Koede/cephalo-1/spec-sheet/page/index.html

Cephalo-1 octopus drone · main arm · spec sheet

# Pin-hinge arm, no helix

1.00 m, 13 joints, hinge axes turning 90 deg per joint. Computed Nov 10, 2026 from the CAD masses and the joint study model.

## What the numbers say

- Hover: lean the fan about 20 deg and the arm holds at 0.18 of stall
  With the fan kept upright (within 3 deg) the best pose found puts 0.67 of stall on joint 2 at hover and 1.42 at full thrust: over your 2x rule, and joint 2 overheats. Let the fan lean off vertical (the eight arms' sideways pushes cancel) and thrust starts carrying the arm: 10 deg gives 0.38 for 1.5 % of lift, 20 deg gives 0.18 at hover and 0.37 at full thrust for 6 % of lift.
- It cannot hold itself out straight with the fan off
  Straight and level, joint 2 needs 1.30 of stall (the helix arm's worst is 1.10). Arched up with the tip held level, it reaches 0.95 m from the root under stall and 0.50 m under your 2x rule. Carrying anything held out needs the fan's help or a short reach.
- Walking on the folded pod: feet need to sit about 45 cm out
  With the feet 30 cm from the hub axis the outer joints (7 to 9, STS3215) run at 1.28 of stall, and 2.75 at twice the foot load. At 35 cm the worst is 0.69; at 45 cm it drops to 0.48, inside your 2x rule. The fold that brings a 1 m arm down to a near foot puts the foot load across the outer joints. 25 cm was out of reach under these clearance rules for both arms.
- The horn screws are the loosest link
  Four M3 screws through 3.4 mm holes in PETG hold 7.0 N.m by friction when new and about 3.5 N.m once the plastic relaxes, which is under an STS3250's 4.9 N.m stall. When it slips, the hole clearance adds up to 1.64 deg of play at that joint. Ream to 3.1 mm and add washers, or bond the ear to the horn.
- Tip play: 9 mm typical, 35 mm worst case as designed; 4 times that if the horn clamps slip
  Servo backlash (0.5 deg each, assumed) is 90 % of it. The 8.4 mm printed idler bores add half again; reamed to 8.05 to 8.10 mm they add almost nothing. Gravity and thrust usually hold every joint against one side of its play, so the tip only wanders this much when the load reverses.
- Root gear contact stress is the long-run limit at joint 0
  At stall the m1 7075 pair sees 547 MPa contact and 155 MPa root bending, fine for peaks; at hover it sees 373 MPa. Anodized aluminium pits under long running above roughly 350 MPa. A steel pinion removes the question.
- Weakest printed part: joint 0 idler ear, safety factor 2.1
  Across every solved hover, tilt, full-thrust and 2x walking load, with PETG at 25 MPa across the layers. Everything clears your 2x rule.
- Servo heat decides the hover pose
  With the fan upright, joint 0 reaches a 50 K rise in 5.5 min, joint 2 reaches a 50 K rise in 2.7 min, joint 4 reaches a 50 K rise in 16.4 min, against a 17 minute flight, and the arm's servos burn 72.8 W. In the 20 deg leaning pose the arm burns 23.4 W and no servo overheats in a flight. A holding servo turns all its input into heat; about 3 W per case is the steady limit (assumed), roughly a fifth of stall torque.
- Landing: it has to land under power
  Dropped 5 cm onto seven folded-pod feet with the servos as the only spring, each foot takes about 86 N and the worst joint sees 3.6 times stall, enough to back-drive or strip a gear train. Let thrust carry the weight to touchdown and hand it over slowly, or add a soft foot pad.

## Configuration and method

- Arm: 1.00 m, 13 pin-hinge joints at 76.9 mm pitch, 57.1 mm outer diameter. Hinge axes turn 90 deg from one joint to the next, so joints alternate pitch (even: 0, 2 … 12) and yaw (odd). That is the closest no-helix layout to the helix arm: same parts, one vertebra STL for every moving link, and pitch and yaw stay separated.
- Servos: STS3250 (4.9 N.m stall, 12 V) in joints 0 to 4, STS3215 (2.94 N.m) in joints 5 to 12, a 2:1 m1 7075 spur stage on joint 0 (9.8 N.m). 6705 support bearings on the horn side of joints 1 to 4, 7075 idler pins on 0 to 4, printed 8 mm PETG stubs on 5 to 12.
- Tip: folding fan pod, 252.5 g, MN5008 KV400 with a 16x5.4 prop 102 mm out; thrust acts along the tip axis.
- Robot: 19.15 kg with the claw-fan wiring. Hover split: 21.53 N per claw fan and 16.2 N from the central prop, about 2820 W.
- Method: hand calculations and a rigid-body model of the arm built from the CAD masses (no FEA). Poses are found by optimisation: each one minimises the worst joint's share of stall under its geometric constraints, from many random starts, so a lower-torque pose may still exist. Tolerances use a 20,000-sample Monte Carlo. Values marked [A] are assumptions; the full list is at the end.

Model, scripts and raw results: octopus-drone/spec-sheet in the project files (spec_lib.py, sec1 to sec5, results/). CAD regenerated without the helix: spec-sheet/cad_alt90.

## Geometry, mass and inertia

Arm, root socket to tip pod1700.4 g

Links (13 vertebrae, servos, lids, bearings, wiring)1316.5 g

Tip pod252.5 g

Root, fixed to the mantle131.4 g

Eight arms13.6 kg (72% of the robot)

Moving mass per arm1.569 kg

CG, arm straight557.7 mm from joint 0

Inertia about the root pitch axis0.6652 kg·m²

Gravity moment at the root, straight out8.58 N.m

Servos per arm5 STS3250, 8 STS3215, 1 STS3032 (pod)

Link | Between | Mass g | CG from joint mm | Servo it carries
0 | joint 0 to 1 | 137.6 | 51.9 | STS3250
1 | joint 1 to 2 | 123.5 | 57.8 | STS3250
2 | joint 2 to 3 | 123.5 | 57.8 | STS3250
3 | joint 3 to 4 | 123.5 | 57.8 | STS3250
4 | joint 4 to 5 | 96.4 | 54.7 | STS3215
5 | joint 5 to 6 | 95.4 | 55.3 | STS3215
6 | joint 6 to 7 | 95.4 | 55.3 | STS3215
7 | joint 7 to 8 | 95.4 | 55.3 | STS3215
8 | joint 8 to 9 | 95.4 | 55.3 | STS3215
9 | joint 9 to 10 | 95.4 | 55.3 | STS3215
10 | joint 10 to 11 | 95.4 | 55.3 | STS3215
11 | joint 11 to 12 | 95.4 | 55.3 | STS3215
12 | joint 12 to tip plate | 44.1 | 45.1 | none

Joint-space inertia (diagonal, arm straight, kg·m²): 0.666, 0.541, 0.432, 0.340, 0.262, 0.197, 0.143, 0.101, 0.067, 0.042, 0.024, 0.012, 0.005.

## Reach, workspace and degrees of freedom

Turning every hinge by 90 deg instead of 60 deg costs almost nothing in reach or workspace. What changes is that pure pitch now uses only every other joint, so the arm bends in coarser steps.

| No helix (90 deg) | Helix (60 deg)
Workspace volume | 0.457 m³ | 0.459 m³
Reach, max / median / min | 0.985 / 0.833 / 0.201 m | 0.985 / 0.832 / 0.248 m
Pitch / yaw joints | 7 / 6 | 13 spread over 3 directions
Shape fit, mean RMS over the study shapes | 33.0 mm | 31.8 mm

Degrees of freedom13 (plus the pod fold)

Command range±45 deg per joint; joints 0, 1 and 12 clear to ±90 deg, neighbours together to ±60

Tightest curl195.9 mm radius (pitch joints 153.8 mm apart, 45 deg each)

Full pitch curl, tip ends at[-208.2, 0.0, 54.4] mm from joint 0

Position resolution4096 counts per turn: 0.088 deg (0.044 deg at joint 0); about 1 mm at the tip, straight

Manipulability, straightsingular values 1.64, 1.47, 0 (no reach along the arm when straight)

## Joint torque demand

hover, fan uprighthover, fan leaning 20 degwalking stance (worst)straight out, fan off

Share of stall torque per joint in the main poses

Flight case | Fan thrust | Worst need | At | Lift lost to lean | Helix arm
Fan upright (within 3 deg), hover | 21.5 N | 0.67 | joint 2 | 0.1% | 0.63
Fan upright (within 3 deg), rated | 25.1 N | 0.89 | joint 2 | 0.1% | 1.04
Fan upright (within 3 deg), full | 33.5 N | 1.42 | joint 2 | 0.1% | 1.60
Fan leaning up to 10 deg, hover | 21.5 N | 0.38 | joint 2 | 1.5% | –
Fan leaning up to 10 deg, rated | 25.1 N | 0.56 | joint 2 | 1.5% | –
Fan leaning up to 10 deg, full | 33.5 N | 0.97 | joint 2 | 1.5% | –
Fan leaning up to 20 deg, hover | 21.5 N | 0.18 | joint 7 | 6.0% | –
Fan leaning up to 20 deg, rated | 25.1 N | 0.23 | joint 10 | 6.0% | –
Fan leaning up to 20 deg, full | 33.5 N | 0.37 | joint 10 | 6.0% | –
Rated thrust, fan tilted 30 deg out | 25.1 N | 0.41 | joint 1 | – | 0.41
Rated thrust, fan tilted 30 deg in | 25.1 N | 1.66 | joint 5 | – | 1.60
Rated thrust, fan tilted 30 deg side | 25.1 N | 1.22 | joint 1 | – | 1.48

Need = joint torque / stall. Green under 0.5 (your 2x rule), amber 0.5 to 1, red above stall. Every pose keeps the fan at least 0.60 m from the robot centre so the 16 in discs clear each other. Leaning fans push sideways; the eight arms' pushes cancel. Poses come from many random starts, so lower ones may exist.

### Walking stance on the folded pod

Arm | Foot radius from the hub axis | Foot points reachable | Worst need | At 2x foot load
No helix | 30 cm | 6/9 | 1.28 | 2.75
No helix | 35 cm | 1/1 | 0.69 | 1.54
No helix | 45 cm | 2/2 | 0.48 | 1.37
Helix | 25 cm | 0/2 | no pose | –
Helix | 30 cm | 0/1 | no pose | –
Helix | 45 cm | 1/1 | 0.56 | 1.52

Same constraints for both arms: hub 250 mm up, tip within 10 deg of down, every link 15 mm clear of the ground and inside its own 36 deg wedge so it cannot reach a neighbour. The design notes' helix stance used a 110 mm hub radius and a direct neighbour check, which is why it found poses at 25 cm.

Pod clocking | Foot | Feasible starts | Worst need | At 2x foot load
pod +x | mid | 0/36 | no pose | –
pod +x | side +45 | 17/36 | 0.99 | 2.17
pod +x | in 34 | 0/36 | no pose | –
pod +y | mid | 21/36 | 1.02 | 2.21
pod +y | side +45 | 18/36 | 1.17 | 2.52
pod +y | in 34 | 19/36 | 1.28 | 2.75
pod -x | mid | 33/36 | 1.01 | 2.24
pod -x | side +45 | 20/36 | 1.02 | 2.25
pod -x | in 34 | 0/36 | no pose | –

Foot = the folded pod's finger tip, with the hub 250 mm above the ground and the tip axis within 10 deg of straight down; 'mid', 'side +45' (45 mm sideways) and 'in 34' (34 mm inward) are three points of the study's step. Pod clocking = which way the folded finger points. Each case: 36 random starts moved onto the constraints, then the best of up to six optimised. 'No pose' means none of the 36 starts reached that foot point.

### Holding the arm out

Tip held level at | Worst need, fan off | Payload at 2x rule kg | Payload to stall kg | Helix arm, worst need
0.30 m | 0.33 | 0.54 | 2.16 | –
0.50 m | 0.44 | 0.09 | 1.01 | –
0.60 m | 0.52 | 0 | 0.68 | –
0.70 m | 0.59 | 0 | 0.49 | –
0.80 m | 0.68 | 0 | 0.38 | –
0.90 m | 0.76 | 0 | 0.23 | –
0.95 m | 0.93 | 0 | 0.05 | –

Tip plate held at that distance from joint 0, level with the root, fan off; payload hangs from the tip plate.

Random poses (±45 deg), thrust along the tip axis | Held at stall | Held under the 2x rule | Helix arm, held at stall
off | 75% | 9% | 95%
hover | 11% | 1% | 12%
rated | 7% | 0% | 7%

1500 random poses each.

## Speed and bandwidth

Case | 0 | 1 | 2 | 3 | 4 | 5 | 6 | 7 | 8 | 9 | 10 | 11 | 12
No load | 2.2 | 4.4 | 4.4 | 4.4 | 4.4 | 4.7 | 4.7 | 4.7 | 4.7 | 4.7 | 4.7 | 4.7 | 4.7
fans off, straight | 0.3 | 4.4 | 0 | 4.4 | 0.3 | 4.7 | 0 | 4.7 | 1.7 | 4.7 | 3.2 | 4.7 | 4.2
hover, fan upright | 1.2 | 4.2 | 1.4 | 4 | 3.1 | 2.5 | 3.8 | 2.8 | 4.3 | 3.7 | 4.4 | 4.7 | 4.7
hover, fan leaning 20 deg | 2.2 | 4.1 | 4.3 | 4 | 4.4 | 3.9 | 4.5 | 3.8 | 4.1 | 4.3 | 3.9 | 4.7 | 4.5

Joint speed in rad/s, derated linearly with the torque each joint is holding (speed falls to zero at stall). Joint 0 runs at half the servo's speed through the 2:1 stage.

Tip speed, joint 0 alone2.2 m/s

Tip speed, all pitch joints together14.75 m/s

First modes, straight1.58 Hz, 1.71 Hz, 9.34 Hz, 9.63 Hz

First modes, hover, fan upright1.93 Hz, 2.43 Hz, 7.23 Hz, 8.02 Hz

First modes, hover, leaning 20 deg1.67 Hz, 1.74 Hz, 9.47 Hz, 9.66 Hz

Servo bus, one per arm at 1 Mbit/s2.89 ms per write-and-read cycle, about 346 Hz

Prop once-per-rev at hoverabout 80 Hz, well above the arm modes

Joint-space modes with the servo hold stiffness above; real servo loops add damping and lag, so treat these as upper bounds. Keep the flight controller's attitude loop under about a third of the first mode, and the prop's once-per-rev (about 80 Hz at hover) is far above them.

## Tolerances, fits and backlash

Part | Fit | Loosens at +40 K, mm | Note
61803 outer ring (26 mm) in printed socket boss | light press, 0.03 to 0.08 mm interference on the as-printed bore (print 25.90, ream or sand to fit) | 0.059 | PETG grows 0.06 mm more than the steel ring at +40 K: a 0.03 mm press is gone by +20 K. Bond the ring with epoxy or keep a lip and a cap.
61803 inner ring (17 mm) on the 7075 gear spigot | 17 k5 (+0.012 / +0.001) on a solid spigot; the hollow spigot as drawn is thin, so 17 j5 (+0.005 / -0.003) plus retaining compound | 0.008 | aluminium grows 0.008 mm more than the ring at +40 K, which tightens this fit slightly
695 outer ring (13 mm) in the printed bearing cap | light press 0.02 to 0.05 mm, bonded | 0.029
695 inner ring on the 5 mm pinion stub | 5 k5 (+0.006 / +0.001) | 0
6705 outer ring (32 mm) in the printed lid ring, joints 1 to 4 | 0 to 0.05 mm interference, bonded | 0.072 | 0.07 mm of loosening at +40 K
6705 inner ring (25 mm) on the printed fork sleeve, joints 1 to 4 | 0.05 to 0.10 mm interference on a sanded sleeve (print 25.20, sand to fit); a printed sleeve creeps, so bond it | -0.057 | the sleeve grows into the ring when warm (tightens 0.04 mm at +40 K); the risk is creep at room temperature
8 mm 7075 idler pin in the printed cheek (joint 0) or cradle back (joints 1 to 4) | pin 8 h6 (0 / -0.009); printed hole 7.80 to 7.85 mm, pressed (0.15 to 0.2 mm into PETG) or bonded in an 8.0 mm hole | 0.014
Fork idler ear on the 8 mm pin or stub (running) | running clearance 0.05 to 0.10 mm diametral: print the bore at 8.0 and ream 8.05 to 8.10, or press an 8 x 10 x 4 mm PTFE or iglide bushing into a 10 mm bore | 0 | as drawn the bore is 8.4 mm (0.4 mm clearance): see the stack-up
Horn screws, 4 x M3 through the 4 mm fork horn ear | clearance hole 3.4 mm as drawn; ream 3.1 mm (or print 3.0 and drill 3.1) | 0 | see the horn clamp check: PETG relaxes the clamp, and then the hole clearance becomes backlash
Gear and pinion centre (30 mm) | +-0.02 mm with reamed seats; +0.05 mm nominal if printed | 0.053 | the printed socket grows 0.05 mm more than the gears at +40 K, which adds 0.04 mm of backlash when hot
Joint pitch (76.92 mm) | +-0.2 mm per printed vertebra (FDM, along the arm axis) | 0.209 | 13 in a row: +-2.6 mm worst case, +-0.7 mm RSS in arm length
PTFE thrust washer, idler ear to cradle floor | 0.5 mm washer; end play 0.05 to 0.15 mm, set with 0.1 mm shims | 0
Servo in its pocket | 0.5 mm clearance per side as drawn; the lid clamps it | 0

### Root gear backlash

Normal backlash mm | Joint 0 play deg
0.03 | 0.091
0.05 | 0.152
0.08 | 0.244
0.1 | 0.305

design normal backlash 0.05 mm (0.15 deg at the joint); bore the gear and pinion bearing seats in one setup or ream them in a drilling jig so the centre distance holds +-0.02 mm; a printed socket alone holds about +-0.1 mm, which swings the backlash from 0 (binding) to 0.12 mm. Set the nominal centre 0.05 mm long (30.05 mm) if the seats stay as printed. each 0.01 mm of centre-distance error changes normal backlash by 2 x 0.01 x tan 20 deg = 0.0073 mm.

### Tip error from play

Build | Pose | RMS mm | 95 % mm | Worst case mm | From hinge backlash
as designed (reamed bores, horn clamp holding, gear 0.05 mm) | straight out | 5.4 | 9.2 | 35.4 | 84%
as designed (reamed bores, horn clamp holding, gear 0.05 mm) | hover pose | 4.2 | 7.2 | 30.4 | 75%
as drawn (8.4 mm bores), horn clamp holding | straight out | 7.4 | 12.7 | 58.2 | 51%
as drawn (8.4 mm bores), horn clamp holding | hover pose | 6.6 | 11.2 | 60.3 | 38%
as drawn, horn clamp relaxed (3.4 mm holes slip) | straight out | 42.1 | 71.1 | 258.2 | 89%
as drawn, horn clamp relaxed (3.4 mm holes slip) | hover pose | 32 | 54.9 | 214.5 | 83%

play only: servo backlash 0.5 deg [A, no maker figure], halved by the 2:1 stage plus the stage's own; idler bore clearance tilts the fork about the two cross axes over the 49 mm ear span; horn-hole slip once the clamp has relaxed. Uniform within each play, 20,000 samples. Gravity or thrust usually preloads every joint to one side of its play, so the repeatable error under a steady load is far smaller than these numbers; they are what the tip can wander when the load reverses.

Horn clamp, new / relaxed7.0 / 3.5 N.m by friction

Arm length tolerance±2.6 mm worst, ±0.72 mm RSS (±0.2 mm per printed link)

Thermal growth0.6 mm per 10 K over the metre

Encoder step at the tip, joint 11.42 mm

## Stiffness and sag

Sag is set almost entirely by how hard each servo holds its position. The printed links are far stiffer than the joints.

Load case | Tip moves (x, y, z) mm | Total mm
straight out, fans off | 0, 0, -110.8 | 110.8
hover pose, hover thrust | -36.5, -9.9, 17.6 | 41.7
hover pose, full thrust | -75.1, -14.6, 36.6 | 84.9
leaning hover pose (20 deg), hover thrust | -3.8, -12, 2.5 | 12.8
stance +x pod, foot load | -25.2, -14.1, 16 | 33
stance +y pod, foot load | -34, 21.9, 16.2 | 43.6
stance -x pod, foot load | -26.9, -20.1, 14.6 | 36.6

Tip stiffness straight, up0.06 N/mm

Tip stiffness straight, sideways0.052 N/mm

Tip stiffness straight, along the armrigid in this model

Servo hold stiffness taken as stall torque per 2 deg of position error [A]: STS3250 140, STS3215 84 N.m/rad, joint 0 550 through the 2:1 stage. Hinge tilt from ear stretch about 4309 N.m/rad [A]. The ring tube (PETG, 2 mm wall) is about 100 times stiffer than the joints and is left rigid. Clearance tilt is play, not spring: see the stack-up.

## Stresses and safety factors

Joint | Pin | Max servo torque N.m | Horn side N | Idler side N | Horn ear MPa | Idler ear MPa | Bore MPa | Pin bend MPa | Min SF | Weakest
0 | 7075 pin | 10.13 | 175 | 162 | 10 | 11.7 | 6.3 | 6.7 | 2.1 | idler ear
1 | 7075 pin | 7.15 | 179 | 177 | 2.3 | 2.8 | 6.9 | 7.4 | 5.1 | idler bore
2 | 7075 pin | 7.21 | 140 | 128 | 2.2 | 2 | 5 | 5.3 | 7 | idler bore
3 | 7075 pin | 5.94 | 145 | 132 | 2.2 | 2 | 5.2 | 5.5 | 6.8 | idler bore
4 | 7075 pin | 5.42 | 123 | 121 | 5.8 | 7.8 | 4.7 | 5.1 | 3.2 | idler ear
5 | printed PETG stub | 4.89 | 114 | 104 | 5.7 | 6.4 | 4.1 | 4.4 | 3.9 | idler ear
6 | printed PETG stub | 5.91 | 132 | 100 | 8.3 | 7.5 | 3.9 | 4.2 | 3 | horn ear
7 | printed PETG stub | 7.29 | 142 | 174 | 2.7 | 3.2 | 6.8 | 7.3 | 4.3 | pin shear
8 | printed PETG stub | 7.4 | 201 | 166 | 10.8 | 10.6 | 6.5 | 6.9 | 2.3 | horn ear
9 | printed PETG stub | 8.07 | 120 | 168 | 2 | 3.9 | 6.5 | 7 | 4.5 | pin shear
10 | printed PETG stub | 5.55 | 142 | 118 | 8.7 | 7.5 | 4.6 | 4.9 | 2.9 | horn ear
11 | printed PETG stub | 3.64 | 58 | 95 | 2.3 | 7.3 | 3.7 | 4 | 3.4 | idler ear
12 | printed PETG stub | 2.55 | 99 | 52 | 5.4 | 3.6 | 2 | 2.2 | 4.7 | horn ear

Envelope over every solved pose and load: straight out with fans off, hover, rated and full thrust, rated thrust tilted 30 deg, walking stance at 1x and 2x foot load. Ear: in-plane bending over the 20.8 mm ear plus direct pull, across the layers. Limits: PETG 25 MPa across layers, 45 along, 35 MPa bearing [A]; 7075-T6 yield 503, shear 290 MPa. Forest's rule is SF >= 2.

### Root gear

Case | Joint torque N.m | Tooth force N | Lewis pinion MPa | Lewis gear MPa | Contact MPa
stall (9.8 N.m) | 9.8 | 500 | 155 | 129 | 547
hover | 4.57 | 233 | 72 | 60 | 373
full thrust | 10.13 | 517 | 160 | 133 | 556
worst solved pose | 10.13 | 517 | 160 | 133 | 556

Lewis Y 0.322 (20T) and 0.389 (40T), 10 mm face, m1. Contact stress at stall is about 540 MPa: fine for short peaks, but hard-anodized 7075 pits under long running above roughly 350 MPa, so keep joint 0 under about 40 % of stall for sustained loads, or make the pinion steel. 7075-T6: yield 503 MPa, bending fatigue about 159 MPa.

### Servo output side load, joints 5 to 12 (no support bearing)

Joint | Horn side load N | Against 40 N (XM430 reference)
5 | 114.2 | 0.4
6 | 132.3 | 0.3
7 | 142 | 0.3
8 | 201 | 0.2
9 | 120.2 | 0.3
10 | 141.7 | 0.3
11 | 58 | 0.7
12 | 98.8 | 0.4

Feetech publishes no side-load limit; ROBOTIS allows 40 N on the similar XM430, used here as a yardstick. The column shows 40 N divided by the load.

Root flange screws (8 x M3)153.1 N worst, safety factor 11.8

Lid screws (4 x M2 into PETG)43.0 N axial worst, safety factor 14.0

## Fatigue and bearing life

Joint | Support load swing N | Ear stress swing MPa | Ear cycles | Pin stress swing MPa | Pin cycles
0 | 2.2 | 0.17 | 1.0e12 | 0.09 | 1.0e12
1 | 12.4 | 0.95 | 1.0e12 | 0.52 | 1.0e12
2 | 2.2 | 0.17 | 1.0e12 | 0.09 | 1.0e12
3 | 0.3 | 0.02 | 1.0e12 | 0.01 | 1.0e12
4 | 5.1 | 0.39 | 1.0e12 | 0.21 | 1.0e12
5 | 23.2 | 1.78 | 1.0e12 | 0.97 | 1.0e12
6 | 27.7 | 2.12 | 1.0e12 | 1.16 | 1.0e12
7 | 33.6 | 2.58 | 2.0e11 | 1.4 | 1.0e12
8 | 38.6 | 2.96 | 3.9e10 | 1.61 | 1.0e12
9 | 32 | 2.45 | 3.6e11 | 1.34 | 1.0e12
10 | 29.5 | 2.27 | 9.2e11 | 1.23 | 1.0e12
11 | 20.4 | 1.56 | 1.0e12 | 0.85 | 1.0e12
12 | 22.8 | 1.75 | 1.0e12 | 0.95 | 1.0e12

One walking step is one load cycle per joint: swing (arm unloaded) to stance (foot load). Basquin: 7075 sigma_f' 1466 MPa, b -0.143; printed PETG across layers sigma_f' 25 MPa, b -0.085 (about 30 % of strength at a million cycles) [A]. Mean stress ignored; printed parts scatter widely, so divide lives by 10 for design.

Joint | Bearing | C / C0 N | Worst static N | Static SF | Stance load N | L10, ±15 deg swings | L10, ±45 deg swings
0 | 61803 (gear) | 2030 / 1270 | 175 | 7.3 | 24 | 3.4e12 | 1.1e12
1 | 6705 (horn side) | 1079 / 834 | 179 | 4.7 | 27 | 4.0e11 | 1.3e11
2 | 6705 (horn side) | 1079 / 834 | 140 | 6 | 25 | 4.9e11 | 1.6e11
3 | 6705 (horn side) | 1079 / 834 | 145 | 5.8 | 29 | 3.0e11 | 1.0e11
4 | 6705 (horn side) | 1079 / 834 | 123 | 6.8 | 28 | 3.5e11 | 1.2e11

Oscillating L10 = (C/P)^3 x 1e6 x 360 / (4 psi). Small swings under 10 deg do not roll the balls far enough to spread grease: expect false brinelling marks at the hover hold angles; a sweep through the full range now and then (a 'grease cycle' at power-up) helps.

## Efficiencies

Stage | Value
Claw fan at hover | 21.53 N for 306.0 W: 7.17 g/W
Claw fan figure of merit (motor and ESC included) | 0.58 (ideal momentum power 177.2 W)
Claw fan at rated / full | 6.68 / 5.78 g/W
Root gear stage | 0.98 (mesh and two bearings) [A]
Servos holding hover, fan upright | 72.8 W per arm, 583 W for the robot (20.7% of hover power)
Servos holding hover, leaning 20 deg | 23.4 W per arm, 187 W for the robot; the lean costs 29.4 W more fan power per arm
Fan wiring, 16 AWG, hover / full | 7.3 W (0.5 V drop) / 27.1 W (0.96 V)
Whole arm at hover | 5.69 g of thrust per W, servos and wiring included

Joint | 0 | 1 | 2 | 3 | 4 | 5 | 6 | 7 | 8 | 9 | 10 | 11 | 12
Upright: torque N.m | 2.33 | 0.18 | 3.29 | 0.39 | 1.39 | 1.4 | 0.55 | 1.2 | 0.23 | 0.6 | 0.17 | 0.01 | 0.02
Upright: heat W | 12.8 | 1.5 | 24.2 | 1.8 | 5.5 | 8.8 | 2.6 | 6.8 | 1.6 | 2.8 | 1.6 | 1.4 | 1.4
Leaning: torque N.m | 0.09 | 0.3 | 0.08 | 0.5 | 0.05 | 0.51 | 0.12 | 0.54 | 0.37 | 0.24 | 0.52 | 0.01 | 0.11
Leaning: heat W | 1.5 | 1.6 | 1.4 | 2 | 1.4 | 2.4 | 1.5 | 2.5 | 2 | 1.6 | 2.5 | 1.4 | 1.5

Servo current in the hover pose = torque / (stall torque / stall current); a holding servo turns it all to heat (I²R plus 0.12 A of electronics at 12 V).

## Thermal

Servo | Winding Ω | N.m per A | Continuous torque N.m | Share of stall | Time constant s
STS3250 | 2.86 | 1.167 | 0.86 | 18% | 1242
STS3215 | 4.44 | 1.089 | 0.65 | 22% | 917

Joint | Upright: heat W | Upright: minutes to +50 K | Leaning 20 deg: heat W | Leaning: minutes to +50 K
0 | 12.8 | 5.5 | 1.5 | never
1 | 1.5 | never | 1.6 | never
2 | 24.2 | 2.7 | 1.4 | never
3 | 1.8 | never | 2 | never
4 | 5.5 | 16.4 | 1.4 | never
5 | 8.8 | 6.4 | 2.4 | never
6 | 2.6 | never | 1.5 | never
7 | 6.8 | 8.8 | 2.5 | never
8 | 1.6 | never | 2 | never
9 | 2.8 | never | 1.6 | never
10 | 1.6 | never | 2.5 | never
11 | 1.4 | never | 1.4 | never
12 | 1.4 | never | 1.5 | never

About 3 W of steady heat per servo case in still air [A]; in the prop wash it is better. 50 K rise from 25 C ambient keeps the case near 75 C, under the 80 C the makers' overheat cut-outs typically sit at [A]. The flight is about 17 minutes. Fan motor: about 55 W of heat at hover.

Keep sustained loads at about a quarter of stall: that is the same line as your 2x rule for the root joints, and a tighter one for the outer joints.

## Resilience

### Dropped onto the folded pods

Drop height m | Fall time s | Peak foot force N | Worst need
0.05 | 0.1 | 86 | 3.63
0.1 | 0.14 | 111 | 4.71
0.2 | 0.2 | 145 | 6.24
0.3 | 0.25 | 172 | 7.41
0.5 | 0.32 | 214 | 9.27
1 | 0.45 | 292 | 12.69
2 | 0.64 | 401 | 17.52

Foot vertical stiffness 1.31 N/mm from the servo springs. Seven feet share the landing, servo springs only (no pad). Above 1.5 x stall the servo gear train back-drives or strips [A]; the last listed height under that is 0 m. Land under power: let thrust carry the weight to touchdown, then hand it over.

### Crash and ground strike, in the leaning hover pose

Tip force direction | Servo stalls at N | Back-drives at N | Printed ear breaks at N
down (landing on the fan) | 11.5 (joint 2) | 17.3 (joint 2) | 119.6 (joint 3)
up | 11.5 (joint 6) | 17.5 (joint 6) | 119.6 (joint 3)
sideways | 5.7 (joint 5) | 8.1 (joint 5) | 15.5 (joint 0)
inward, toward the body | 6.0 (joint 6) | 9.1 (joint 6) | 73.5 (joint 3)
outward | 6.5 (joint 6) | 9.6 (joint 6) | 73.5 (joint 3)

Extra static force at the tip plate on top of hover thrust, arm in the leaning hover pose, servos holding. A real hit is dynamic: the servos give way first when the hit is along a hinge axis, but an end-on hit loads only the ears and pins. Gravity is included.

### Losing a servo, a fan or power

Failure | Result
One servo goes limp in hover | joint 0: arm can re-pose and hold; joint 1: arm can re-pose and hold; joint 2: arm can re-pose and hold; joint 4: arm can re-pose and hold; joint 6: arm can re-pose and hold; joint 8: arm can re-pose and hold; joint 10: arm can re-pose and hold; joint 12: arm can re-pose and hold
One claw fan out | Hover holds: the worst remaining fan runs at 72% of full, central prop 45 N.
Central prop out | Hover holds: each claw fan needs 23.5 N (70% of full), 2781 W in all.
Servo bus voltage sags | The upright hover pose holds down to 8.1 V (your 2x rule would need 16.1 V, above the 12 V supply); the leaning pose holds down to 2.2 V (4.4 V for 2x). Stall torque falls in proportion to voltage. The STS servos cut out near 4 to 5 V by default [A]. Feed each arm's 12 V bus from its own buck regulator (about 10 A peak per arm) so one arm's stall cannot pull the others down; the pack sags from 25 V to about 21 V under hover load, which a buck converter absorbs.
Overload and back-drive | Feetech STS servos have torque limit, protection current and overload protection time registers. In flight a servo that trips goes limp, which is worse than running hot, so for joints 0 to 4 set the overload torque to 100 % and the protection time to its maximum, and let the flight controller's own current watch decide. For walking, a 80 % torque limit makes the arm give way before the gears strip. Metal gear trains in this size back-drive around 1.5 x stall [A]; above that teeth chip.

A dead servo leaves its joint free (no brake). The other joints move so that thrust and gravity put no torque on the free joint, with the fan still within 20 deg of up and 0.6 m out. If that fails the arm should cut its fan and fold (neutral thrust).

## Sensitivity to the unknowns

Tip pod and claw g | Arm mass g | Hover (leaning 20 deg) worst need | Straight out, fan off
150 | 1598 | 0.40 | 1.12
200 | 1648 | 0.39 | 1.21
252.5 | 1700 | 0.37 | 1.30
300 | 1748 | 0.34 | 1.39
350 | 1798 | 0.31 | 1.48
400 | 1848 | 0.27 | 1.56

Hub radius m | Hover (leaning 20 deg) worst need
0.11 | 0.32
0.1245 | 0.37
0.14 | 0.38
0.16 | 0.32

Hover here is the leaning (20 deg) hover pose, re-solved for each case. Claw mass: the tip pod mass stands in for it (the claw sits in the pod). Mantle radius: changes the hub radius where the roots sit, which moves the 0.6 m fan circle closer to or further from the root, and the walking foot radius in the same way. Each hover case re-solves the pose from a warm start, so small differences are within the solver's scatter.

## No helix against the helix

Same parts, masses and servos; only the hinge directions change. Both columns are solved the same way.

| No helix (90 deg) | Helix (60 deg)
Hover, fan upright, worst need | 0.67 | 0.63
Rated thrust, fan upright, worst need | 0.89 | 1.04
Straight out, fan off, worst need | 1.30 | 1.10
Walking, worst need at 30 cm feet | 1.28 | –
Walking, worst need at 45 cm feet | 0.48 | 0.56
Workspace | 0.457 m³ | 0.459 m³
Minimum reach | 0.201 m | 0.248 m
Pure pitch bend | 7 joints, 196 mm curl radius | spread over every joint
Parts | one vertebra STL for every moving link | one vertebra STL, turned 60 deg

## Assumptions [A]

1. Servo stall torque and current are the makers' 12 V figures; servo backlash 0.5 deg; hold stiffness = stall torque per 2 deg of error.
2. Metal gear trains back-drive or chip at about 1.5 x stall.
3. Printed PETG: 45 MPa along layers, 25 MPa across, 35 MPa bearing, E 2.0 GPa, fatigue 30 % of strength at a million cycles. Prints vary; test a coupon.
4. 7075-T6: yield 503 MPa, bending fatigue 159 MPa, Basquin 1466 MPa and -0.143.
5. Servo case sheds about 3 W steadily in still air; 50 K rise allowed.
6. Hub radius 124.5 mm (the smallest at which the eight root flanges clear); mantle not drawn.
7. Tip pod 252.5 g with its CG 45 mm beyond the tip plate; real claw mass unknown, swept 150 to 400 g.
8. Horn screws at 0.5 N.m, friction 0.3, PETG relaxes half the clamp.
9. Root gear: m1, 20T / 40T, 10 mm face, 98 % efficient; centre held ±0.02 mm only with reamed seats.
10. Fan thrust and power from the maker's MN5008 16x5.4 table, 5 % derated at 6S under load.
11. No FEA: ears, pins and bores use beam and bearing formulas with the support reactions split over the two ears 49 mm apart.

Hand calculations and a rigid-body model, no FEA. Numbers marked [A] rest on assumptions listed above. Source: octopus-drone/spec-sheet.
