Koede/cephalo-1/arm-pin-hinge/out/render.png

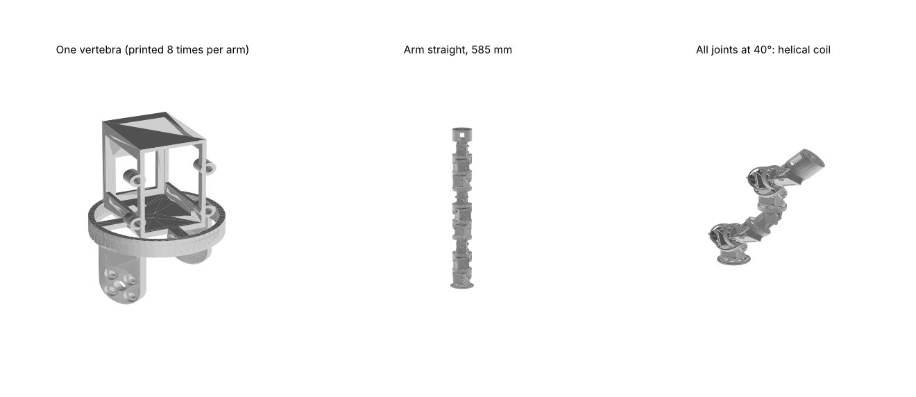
arm-pin-hinge/out/render.png
