Koede/cephalo-1/arm-pin-hinge/out_1m_13/root_gear_check.png

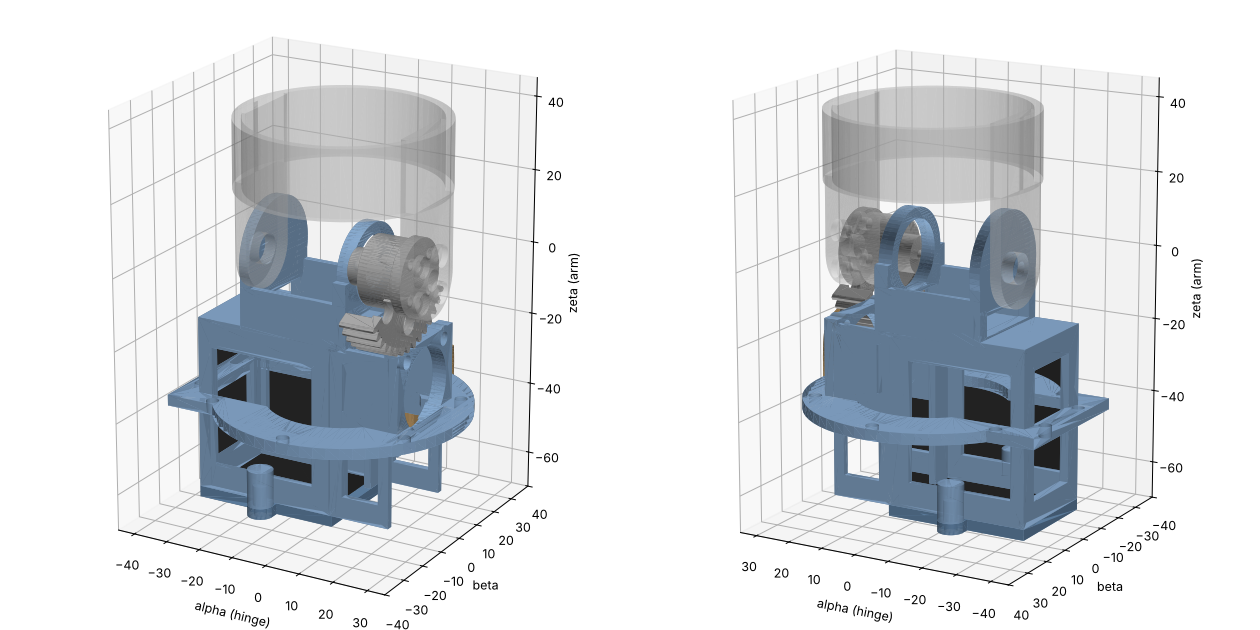
arm-pin-hinge/out_1m_13/root_gear_check.png
