Koede/cephalo-1/joint-study/results/585mm/family_by_architecture.png

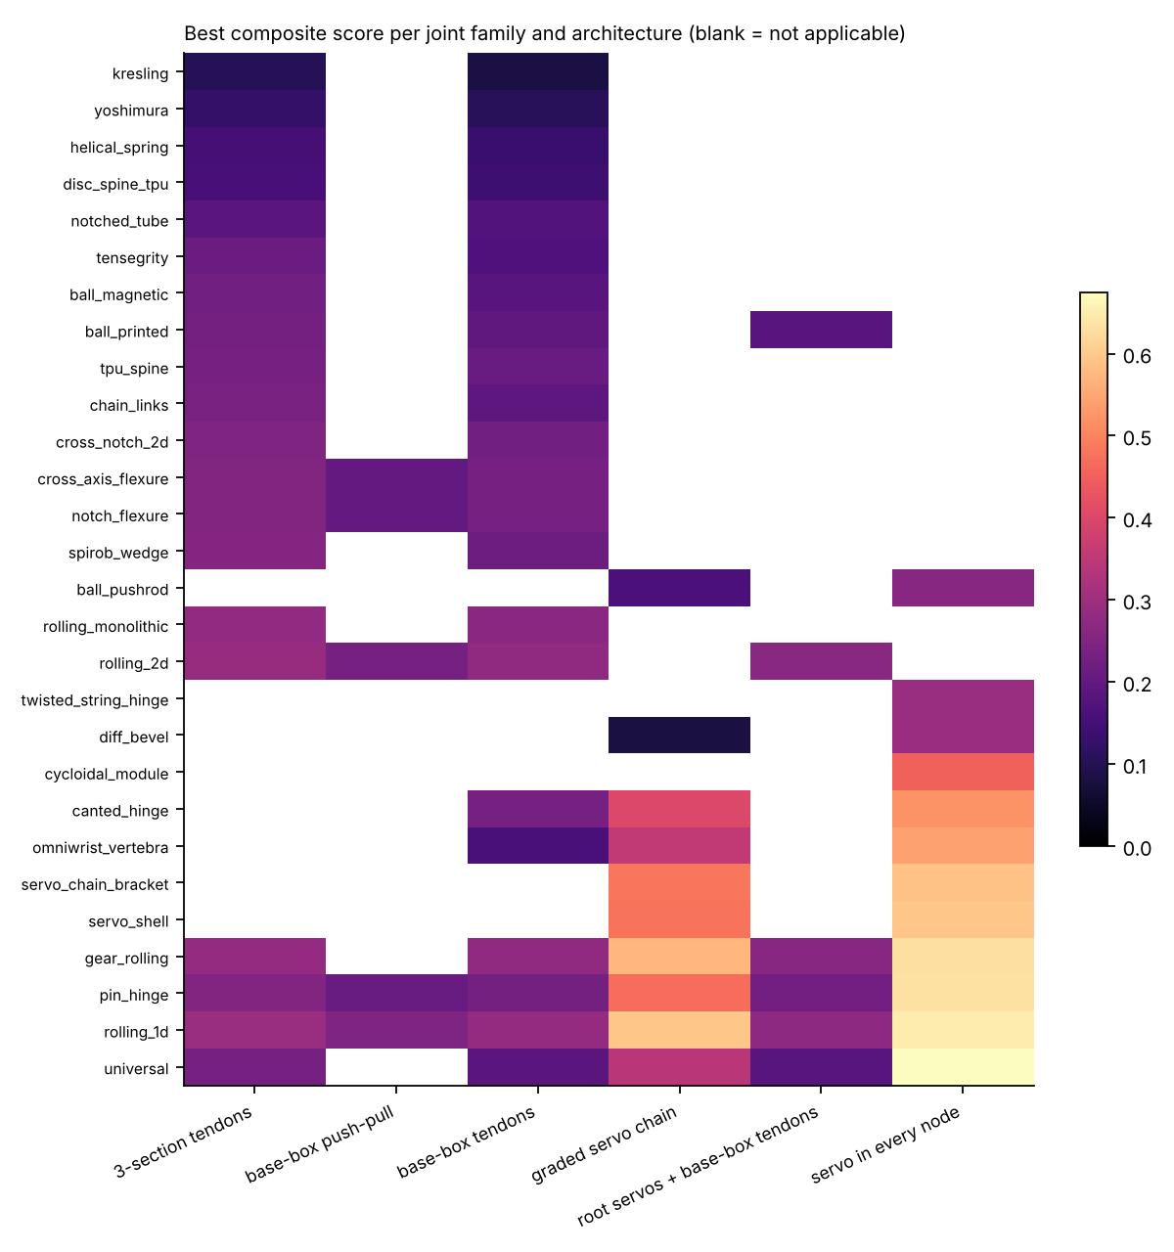
joint-study/results/585mm/family_by_architecture.png
