Koede/cephalo-1/joint-study/results/family_by_architecture.png

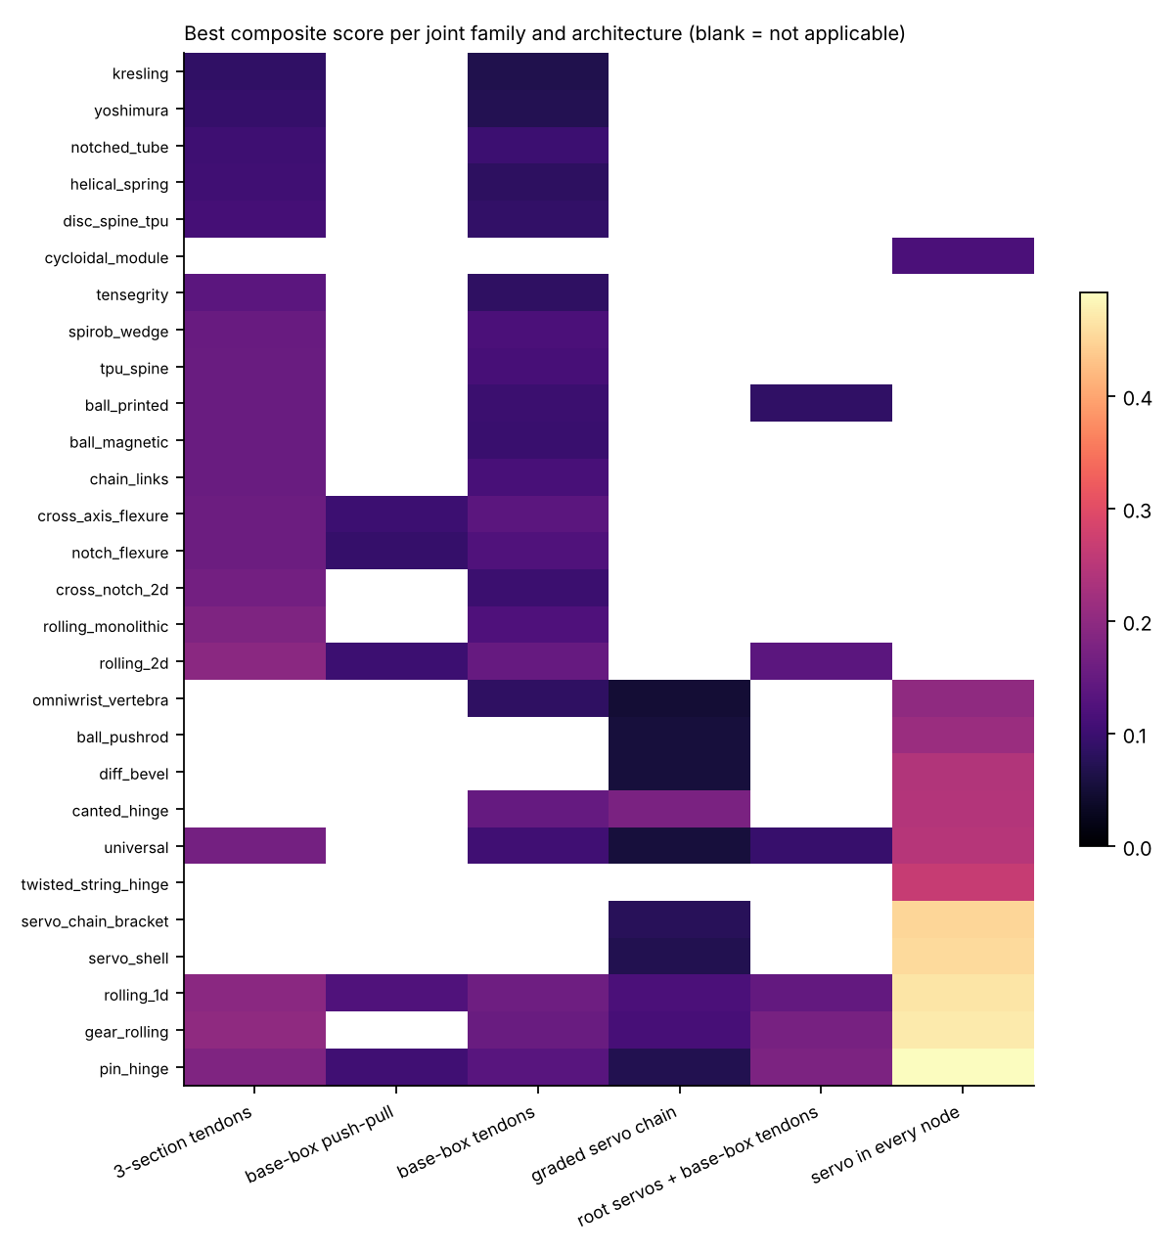
joint-study/results/family_by_architecture.png
