Koede/cephalo-1/arm-canted-hinge/out/assembly_coil.stl

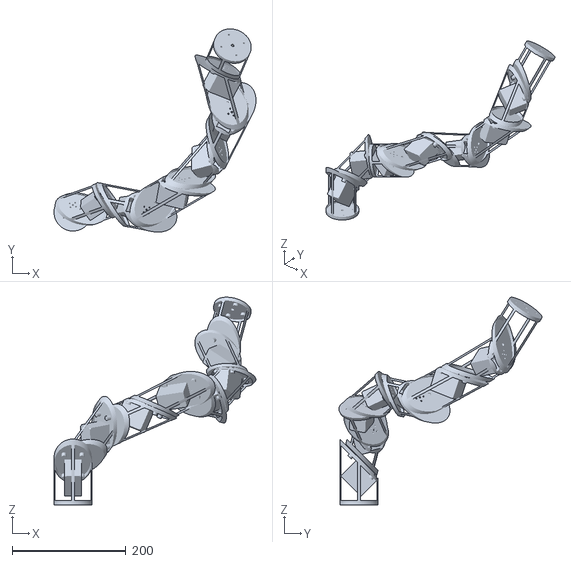
[picture p5: CAD file, 2026-11-10]
arm-canted-hinge/out/assembly_coil.stl
355.1 x 357.3 x 365.0
