Koede/cephalo-1/arm-pin-hinge/out/assembly_curl.stl

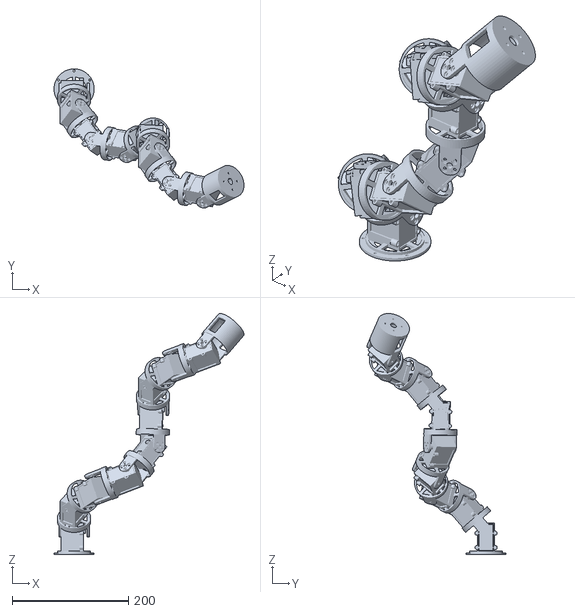
[picture p6: CAD file, 2026-11-10]
arm-pin-hinge/out/assembly_curl.stl
326.8 x 239.5 x 414.6
