Koede/cephalo-1/arm-pin-hinge/out_1m_13/fan_pod/assembly_pod_45deg.stl

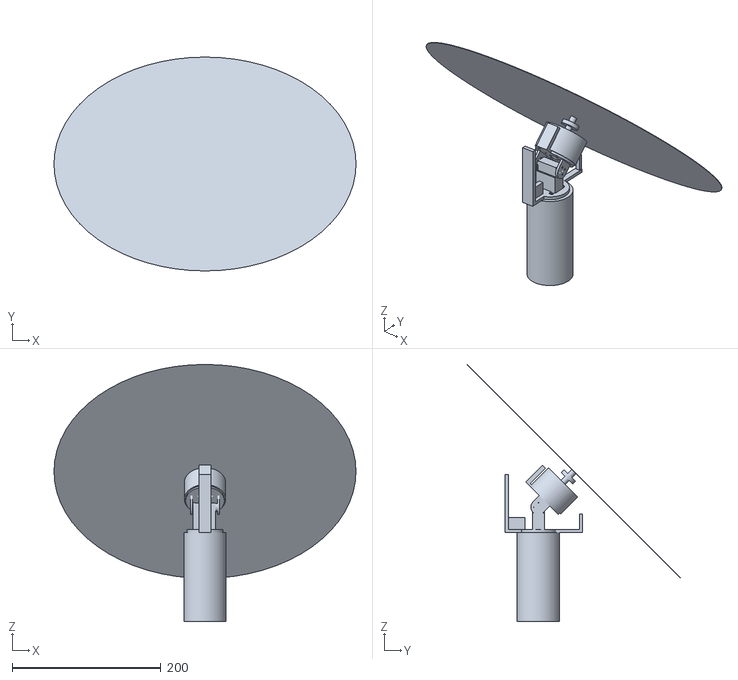
[picture p7: CAD file, 2026-11-10]
arm-pin-hinge/out_1m_13/fan_pod/assembly_pod_45deg.stl
406.4 x 287.8 x 346.0
