Koede/cephalo-1/arm-pin-hinge/out_1m_13/horn_bearing/assembly_joint1_bearing.stl

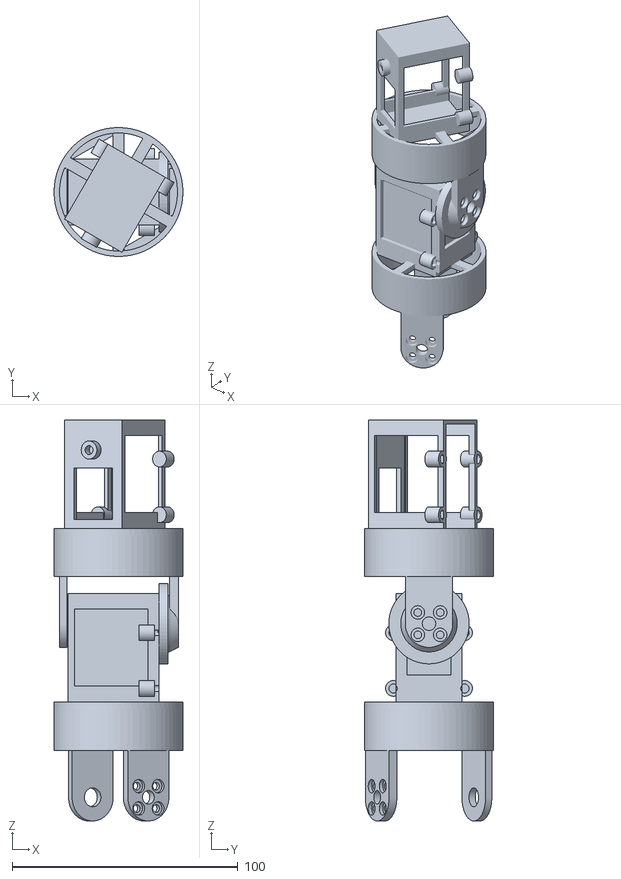
[picture p8: CAD file, 2026-11-10]
arm-pin-hinge/out_1m_13/horn_bearing/assembly_joint1_bearing.stl
57.1 x 57.1 x 177.6
