Koede/cephalo-1/arm-pin-hinge/out_1m_7/assembly_curl.stl

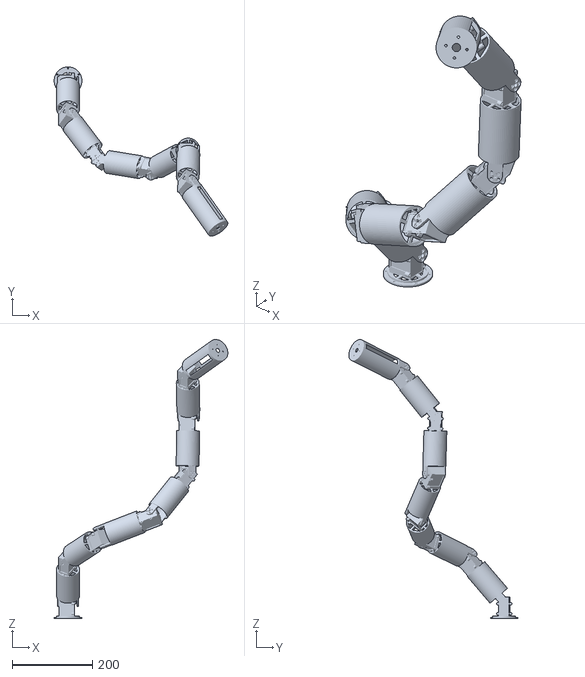
[picture p9: CAD file, 2026-11-10]
arm-pin-hinge/out_1m_7/assembly_curl.stl
431.7 x 420.5 x 693.3
