Koede/cephalo-1/arm-pin-hinge/out_700_9/assembly_straight.stl

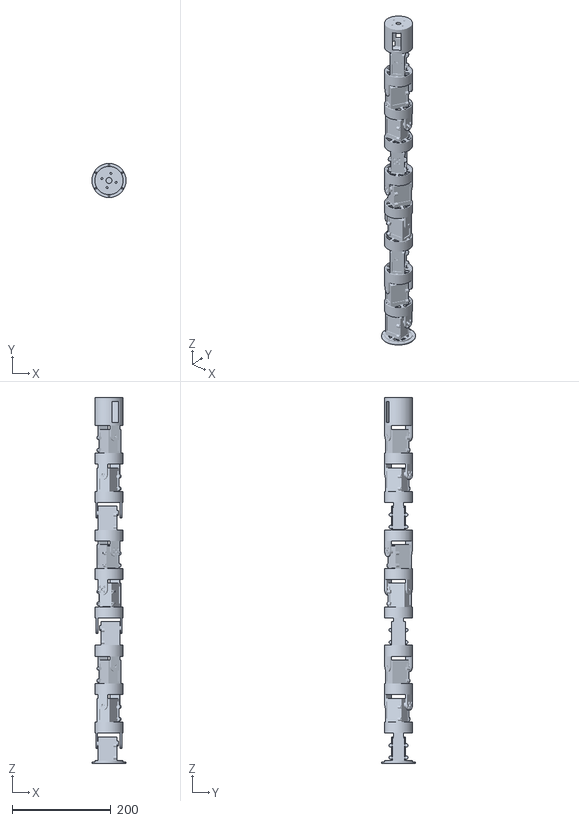
[picture p10: CAD file, 2026-11-10]
arm-pin-hinge/out_700_9/assembly_straight.stl
69.1 x 69.1 x 740.7
