Koede/cephalo-1/spec-sheet/cad_alt90/assembly_curl.stl

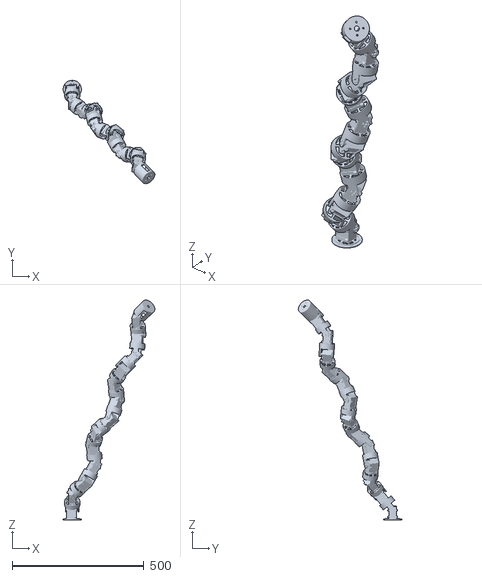
[picture p11: CAD file, 2026-11-10]
spec-sheet/cad_alt90/assembly_curl.stl
347.6 x 392.3 x 833.8
