Koede/cephalo-1/arm-canted-hinge/out/assembly_curl.stl

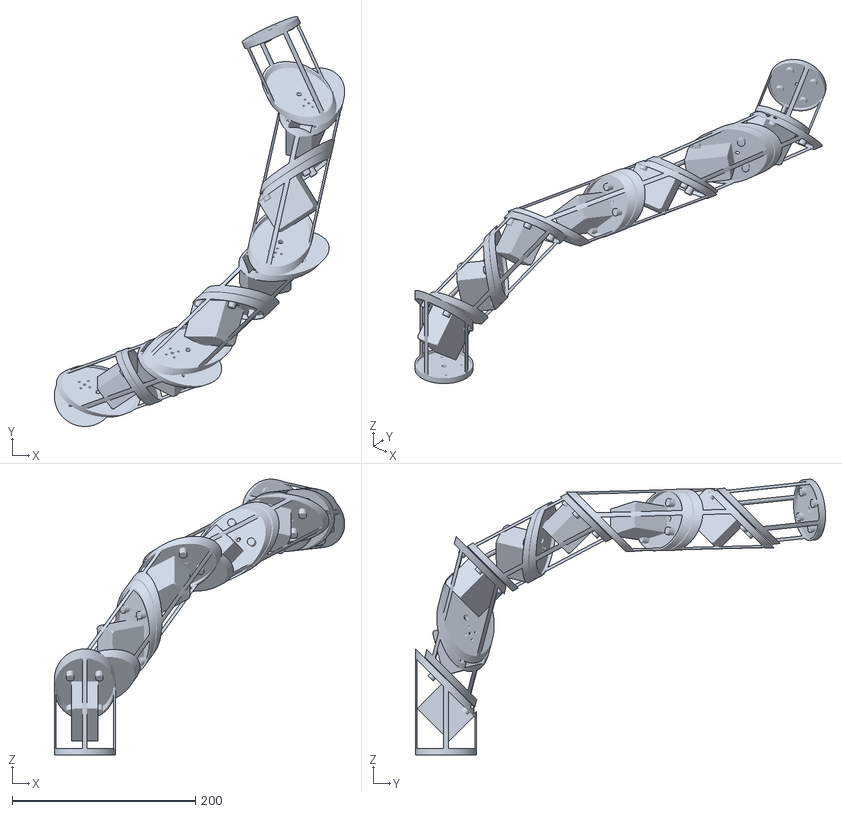
[picture p12: CAD file, 2026-11-10]
arm-canted-hinge/out/assembly_curl.stl
316.8 x 447.3 x 300.9
