Koede/cephalo-1/arm-pin-hinge/out/assembly_wave.stl

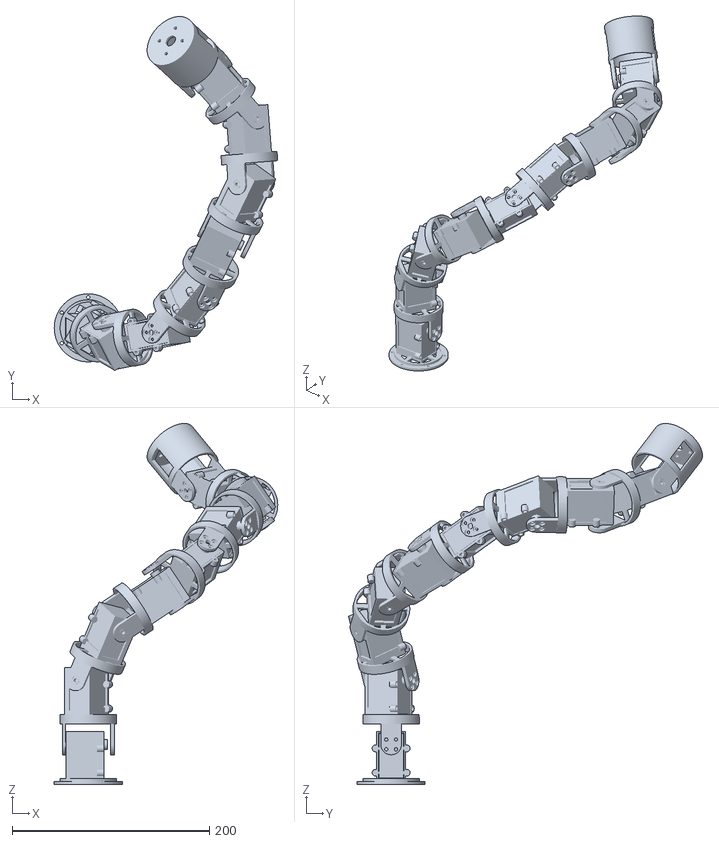
[picture p13: CAD file, 2026-11-10]
arm-pin-hinge/out/assembly_wave.stl
226.9 x 359.4 x 366.5
