Koede/cephalo-1/arm-pin-hinge/out_1m_13/assembly_wave.stl

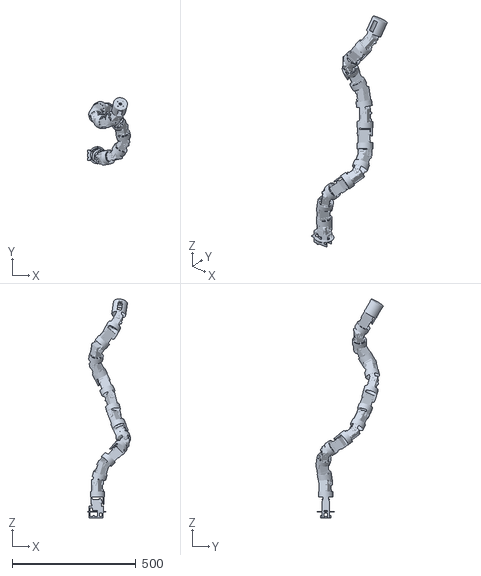
[picture p14: CAD file, 2026-11-10]
arm-pin-hinge/out_1m_13/assembly_wave.stl
175.5 x 274.0 x 885.9
