Koede/cephalo-1/arm-pin-hinge/out_1m_13/fan_pod/assembly_pod_0deg.stl

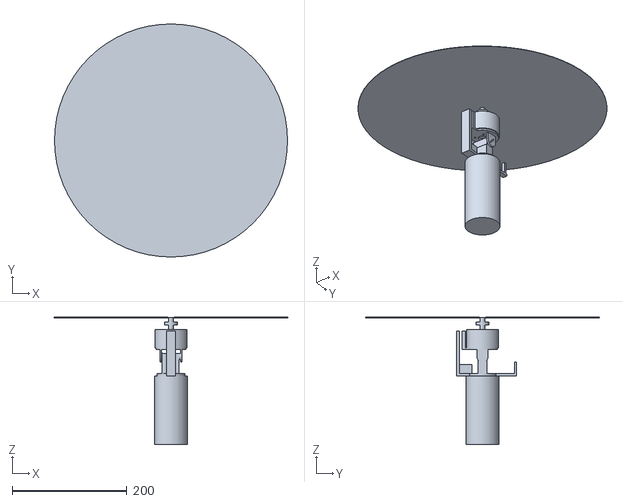
[picture p15: CAD file, 2026-11-10]
arm-pin-hinge/out_1m_13/fan_pod/assembly_pod_0deg.stl
406.4 x 406.4 x 222.3
