Koede/cephalo-1/arm-pin-hinge/out_1m_7/assembly_straight.stl

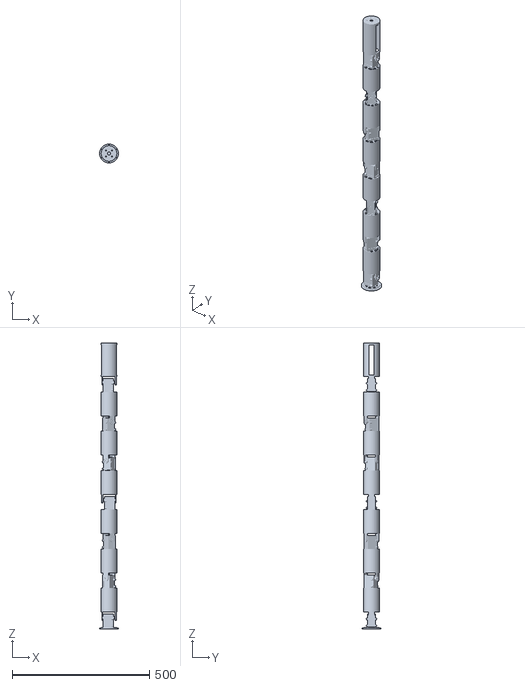
[picture p16: CAD file, 2026-11-10]
arm-pin-hinge/out_1m_7/assembly_straight.stl
69.1 x 69.1 x 1040.7
