Koede/cephalo-1/arm-pin-hinge/out_700_9/assembly_wave.stl

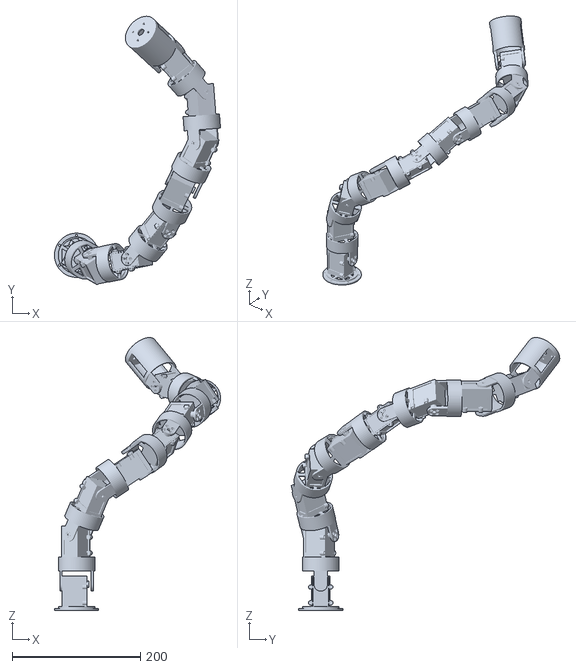
[picture p17: CAD file, 2026-11-10]
arm-pin-hinge/out_700_9/assembly_wave.stl
259.5 x 419.5 x 426.4
