Koede/cephalo-1/spec-sheet/cad_alt90/assembly_straight.stl

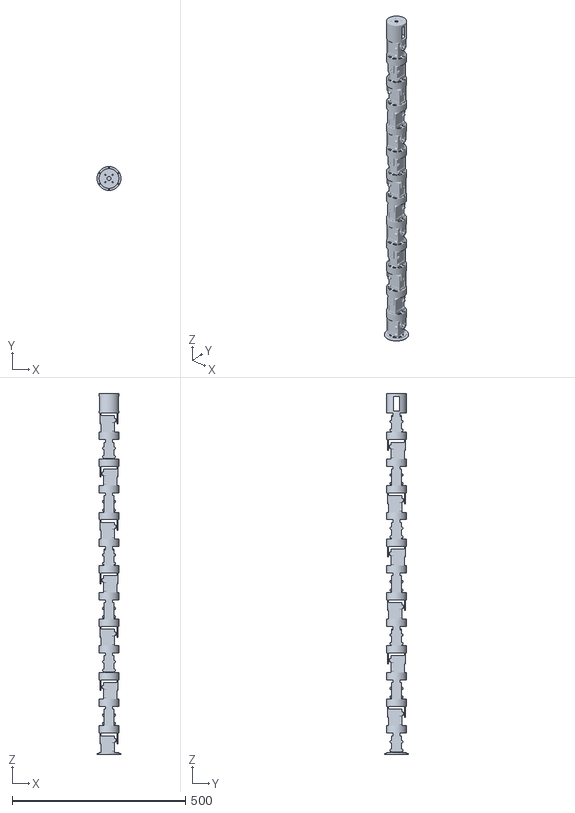
[picture p18: CAD file, 2026-11-10]
spec-sheet/cad_alt90/assembly_straight.stl
69.1 x 69.1 x 1040.7
