Koede/cephalo-1/arm-canted-hinge/out/assembly_straight.stl

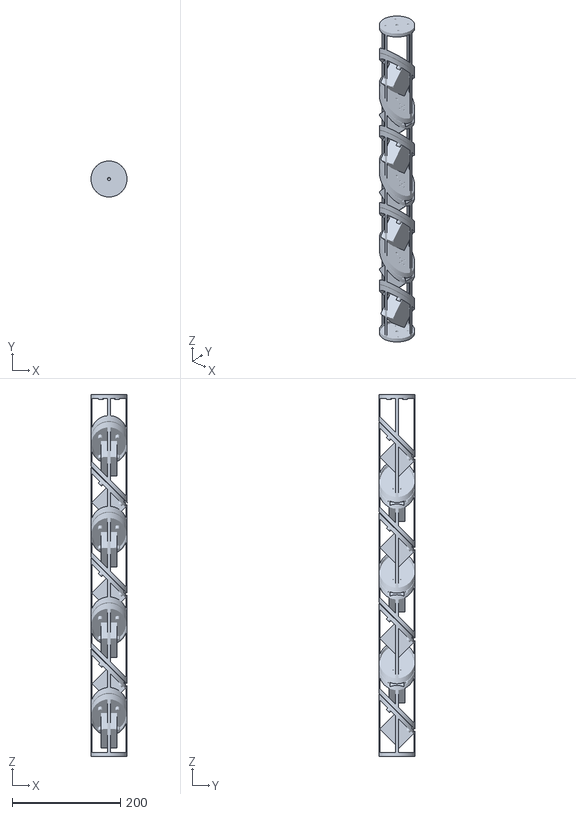
[picture p19: CAD file, 2026-11-10]
arm-canted-hinge/out/assembly_straight.stl
66.6 x 66.6 x 667.6
