Koede/cephalo-1/arm-pin-hinge/out/assembly_straight.stl

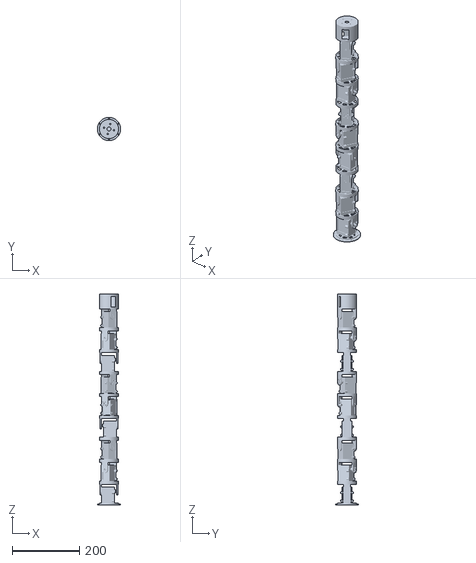
[picture p20: CAD file, 2026-11-10]
arm-pin-hinge/out/assembly_straight.stl
69.1 x 69.1 x 625.7
