Koede/cephalo-1/arm-pin-hinge/out_1m_13/assembly_root_gear.stl

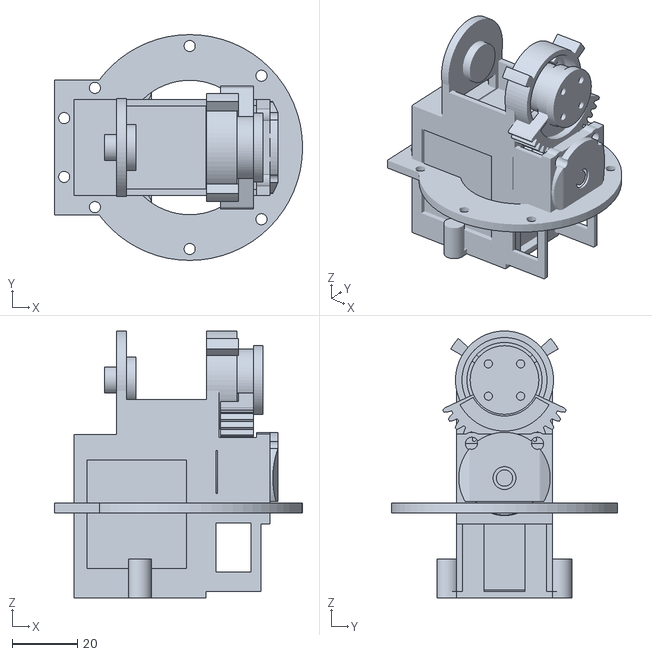
[picture p21: CAD file, 2026-11-10]
arm-pin-hinge/out_1m_13/assembly_root_gear.stl
76.0 x 69.1 x 81.7
