Koede/cephalo-1/arm-pin-hinge/out_1m_13/fan_pod/assembly_pod_88deg.stl

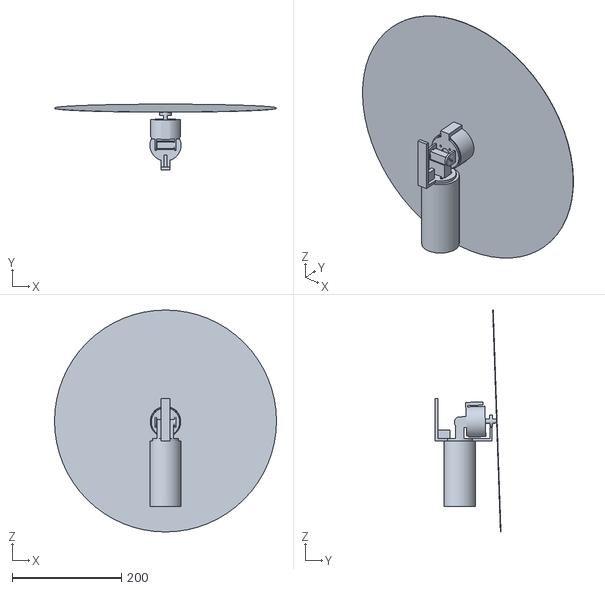
[picture p22: CAD file, 2026-11-10]
arm-pin-hinge/out_1m_13/fan_pod/assembly_pod_88deg.stl
406.4 x 120.3 x 406.2
