Koede/cephalo-1/arm-pin-hinge/out_1m_7/assembly_wave.stl

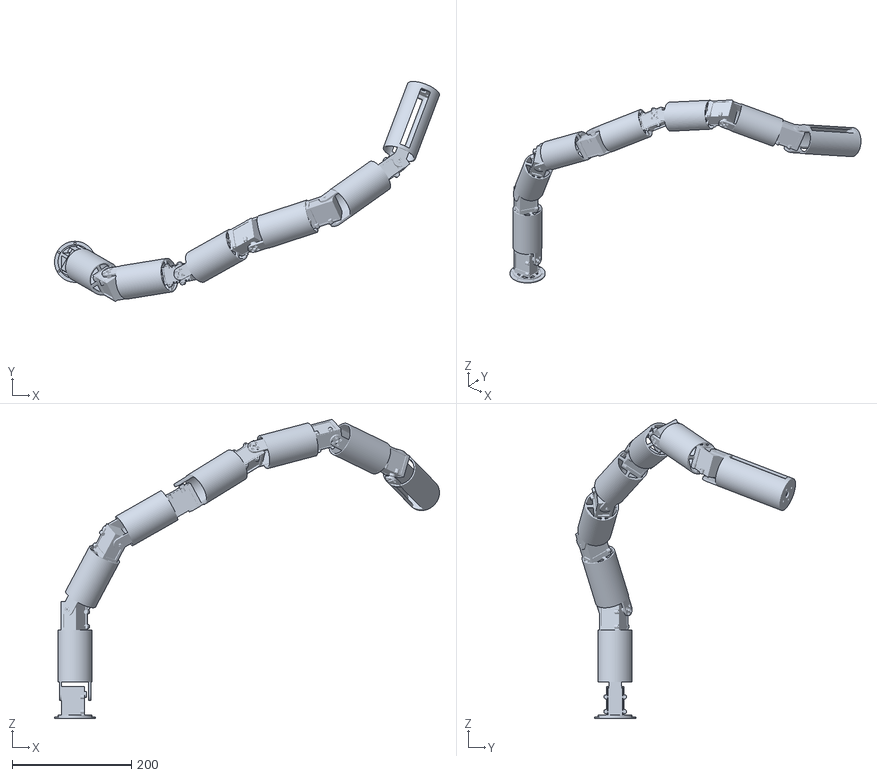
[picture p23: CAD file, 2026-11-10]
arm-pin-hinge/out_1m_7/assembly_wave.stl
646.8 x 369.8 x 503.0
