Koede/cephalo-1/arm-pin-hinge/out_700_9/assembly_curl.stl

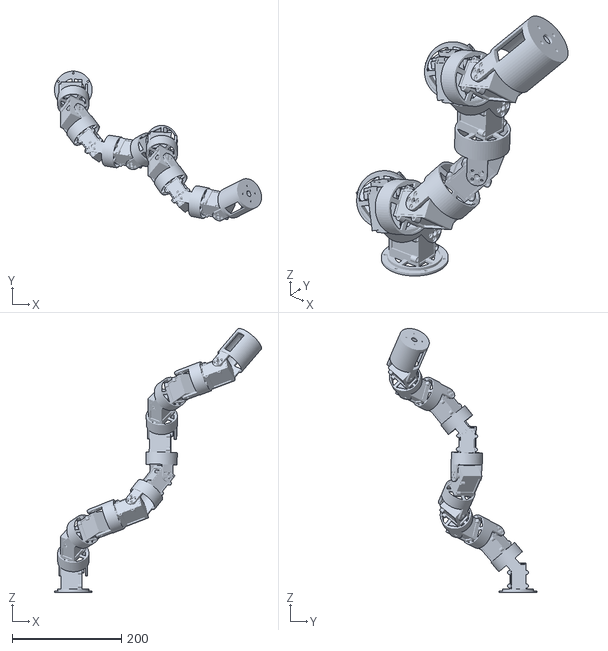
[picture p24: CAD file, 2026-11-10]
arm-pin-hinge/out_700_9/assembly_curl.stl
379.8 x 274.7 x 484.2
