Koede/cephalo-1/spec-sheet/cad_alt90/assembly_wave.stl

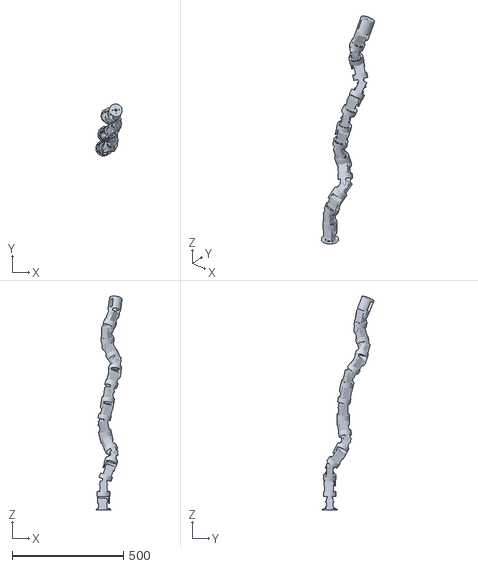
[picture p25: CAD file, 2026-11-10]
spec-sheet/cad_alt90/assembly_wave.stl
118.5 x 233.7 x 962.4
