Koede/cephalo-1/arm-pin-hinge/out_1m_13/assembly_curl.stl

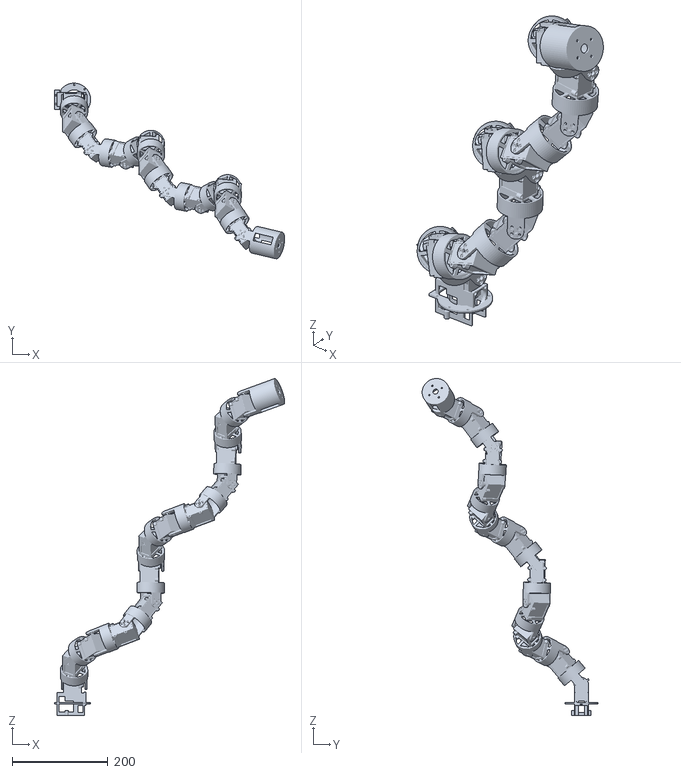
[picture p26: CAD file, 2026-11-10]
arm-pin-hinge/out_1m_13/assembly_curl.stl
481.8 x 367.6 x 704.9
