Koede/cephalo-1/arm-pin-hinge/out_1m_13/assembly_straight.stl

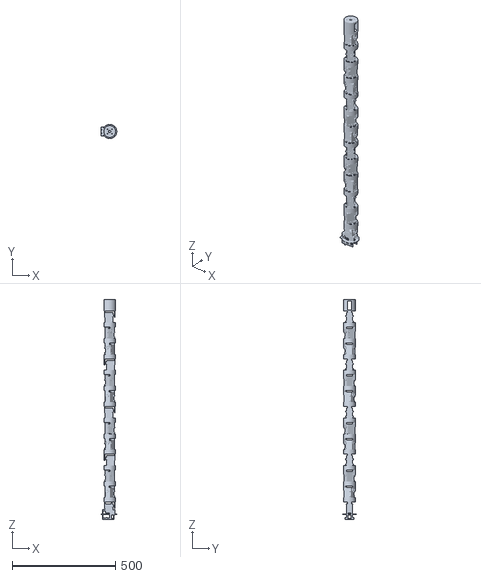
[picture p27: CAD file, 2026-11-10]
arm-pin-hinge/out_1m_13/assembly_straight.stl
76.0 x 69.1 x 1064.7
