Koede/cephalo-1/arm-canted-hinge/out/stl/servo_retainer_x7.stl

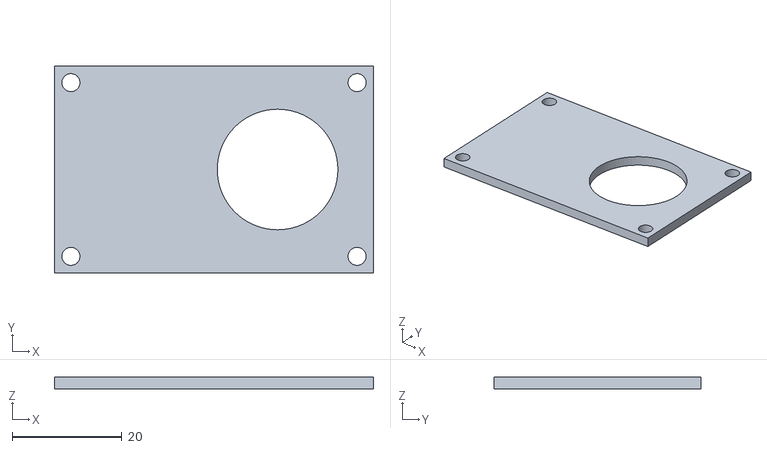
[picture p28: CAD file, 2026-11-10]
arm-canted-hinge/out/stl/servo_retainer_x7.stl
58.2 x 37.7 x 2.20
