Koede/cephalo-1/arm-pin-hinge/out_1m_13/fan_pod/stl/palm_finger_x8.stl

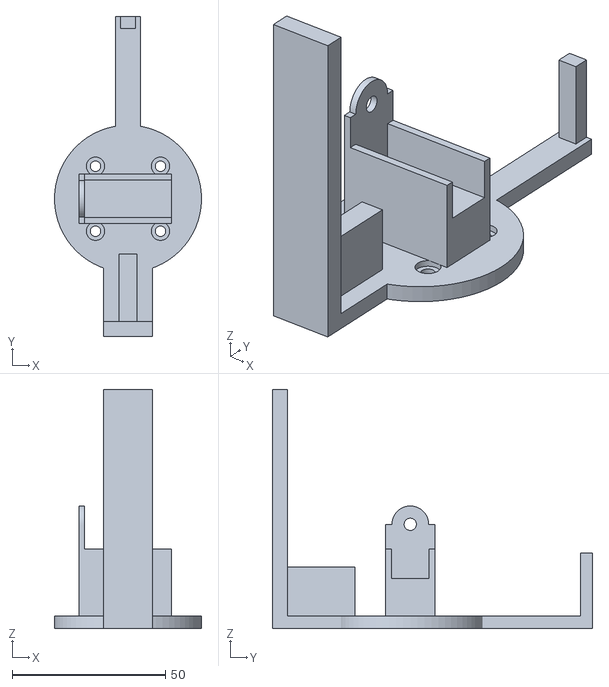
[picture p30: CAD file, 2026-11-10]
arm-pin-hinge/out_1m_13/fan_pod/stl/palm_finger_x8.stl
48.0 x 104.5 x 78.0
