Koede/cephalo-1/arm-pin-hinge/out_1m_13/horn_bearing/stl/servo_lid_bearing_x4.stl

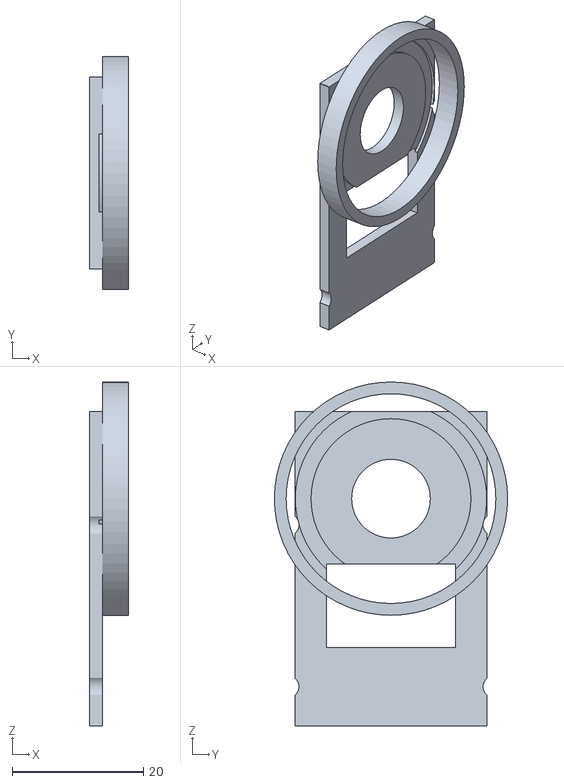
[picture p31: CAD file, 2026-11-10]
arm-pin-hinge/out_1m_13/horn_bearing/stl/servo_lid_bearing_x4.stl
6.00 x 35.6 x 52.5
