Koede/cephalo-1/arm-pin-hinge/out_1m_13/mantle_port_cutter_joint0_frame.stl

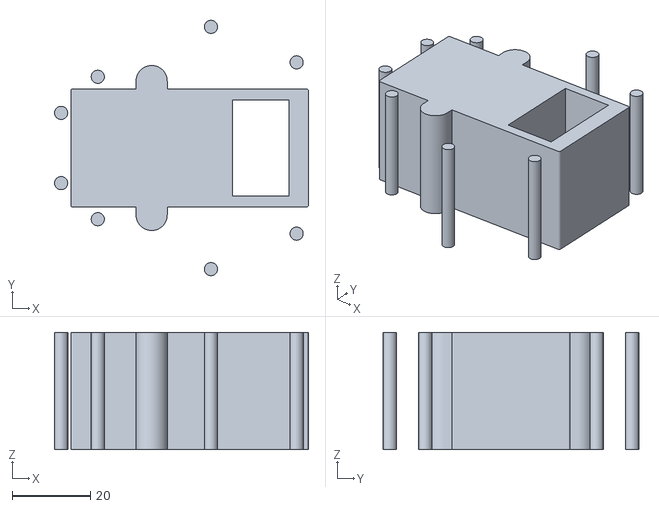
[picture p32: CAD file, 2026-11-10]
arm-pin-hinge/out_1m_13/mantle_port_cutter_joint0_frame.stl
65.1 x 65.5 x 30.0
