Koede/cephalo-1/arm-pin-hinge/out_1m_13/stl/idler_pin_8mm_7075_x1.stl

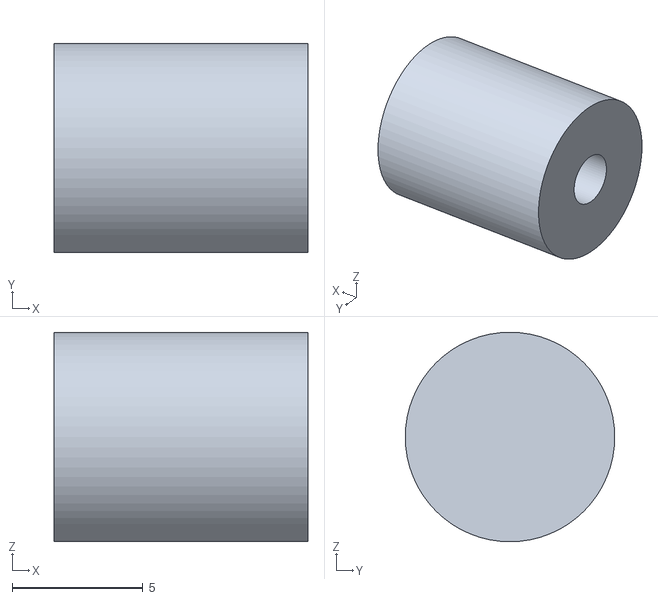
[picture p33: CAD file, 2026-11-10]
arm-pin-hinge/out_1m_13/stl/idler_pin_8mm_7075_x1.stl
9.70 x 8.00 x 8.00
