Koede/cephalo-1/arm-pin-hinge/out_1m_7/stl/servo_lid_x7.stl

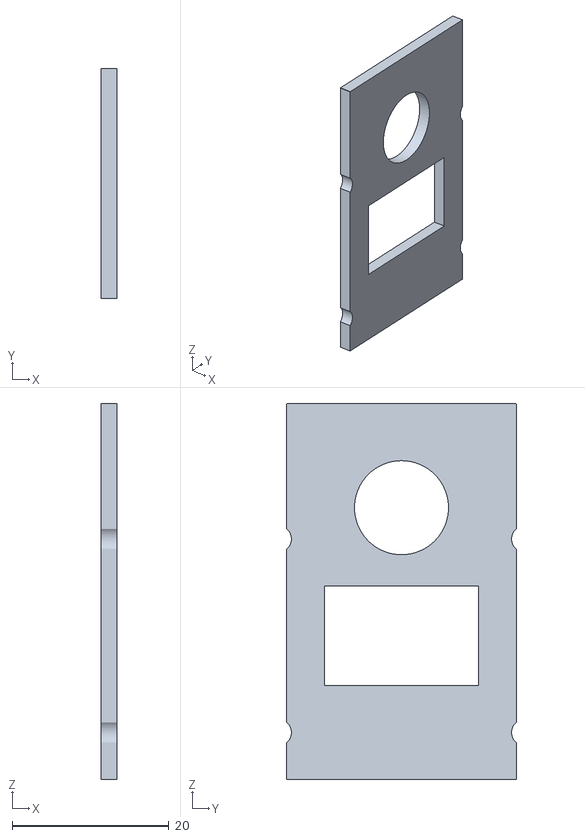
[picture p34: CAD file, 2026-11-10]
arm-pin-hinge/out_1m_7/stl/servo_lid_x7.stl
2.00 x 29.3 x 48.0
