Koede/cephalo-1/arm-canted-hinge/out/stl/vertebra_02.stl

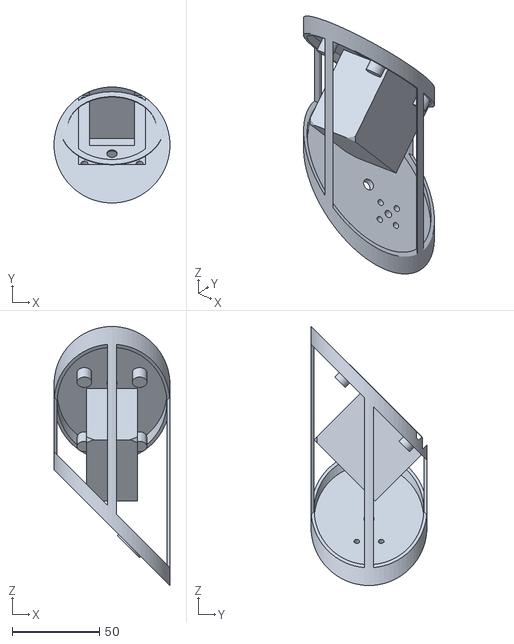
[picture p35: CAD file, 2026-11-10]
arm-canted-hinge/out/stl/vertebra_02.stl
66.6 x 66.6 x 148.7
