Koede/cephalo-1/arm-pin-hinge/out/stl/root_socket_x1.stl

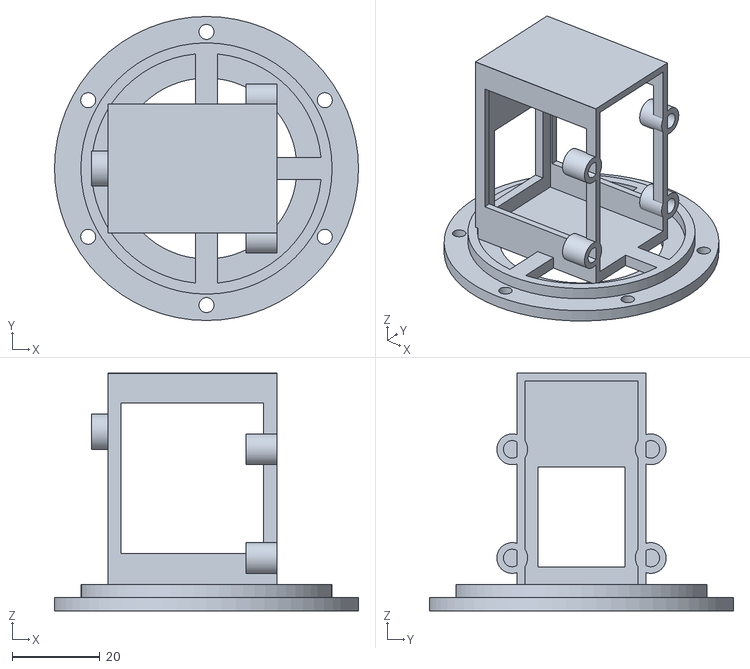
[picture p36: CAD file, 2026-11-10]
arm-pin-hinge/out/stl/root_socket_x1.stl
69.1 x 69.1 x 54.0
