Koede/cephalo-1/arm-pin-hinge/out_1m_13/fan_pod/stl/fan_pod_x8.stl

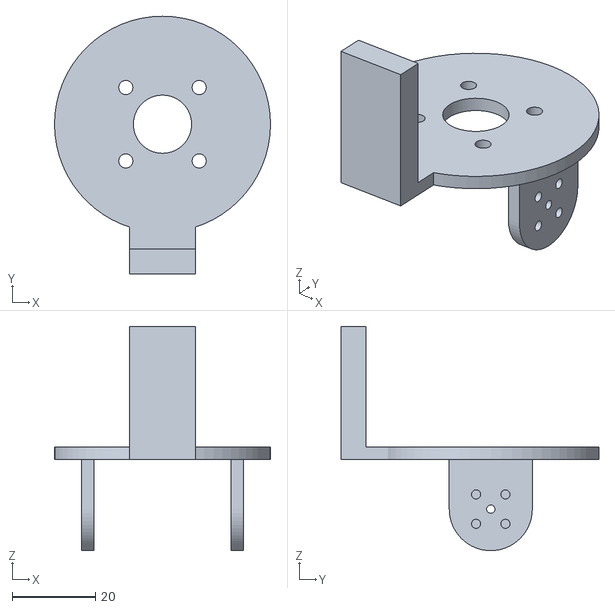
[picture p37: CAD file, 2026-11-10]
arm-pin-hinge/out_1m_13/fan_pod/stl/fan_pod_x8.stl
52.0 x 62.0 x 54.0
