Koede/cephalo-1/arm-pin-hinge/out_1m_13/horn_bearing/stl/vertebra_bearing_x4.stl

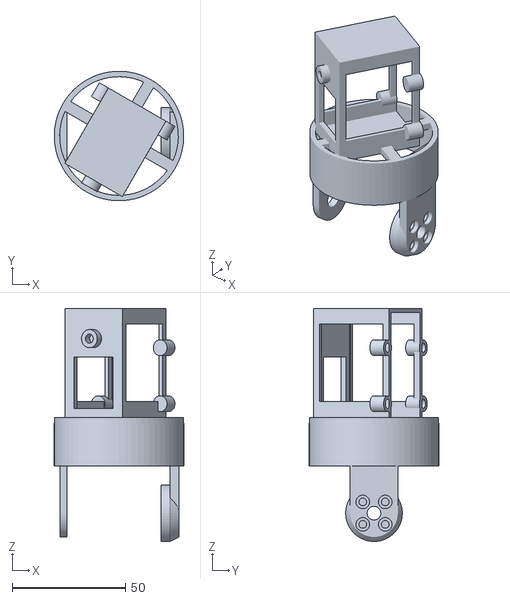
[picture p38: CAD file, 2026-11-10]
arm-pin-hinge/out_1m_13/horn_bearing/stl/vertebra_bearing_x4.stl
57.1 x 57.1 x 102.7
