Koede/cephalo-1/arm-pin-hinge/out_1m_7/stl/tip_vertebra_x1.stl

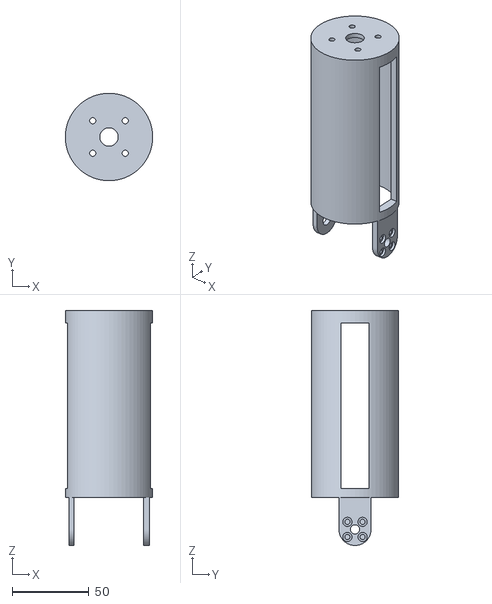
[picture p39: CAD file, 2026-11-10]
arm-pin-hinge/out_1m_7/stl/tip_vertebra_x1.stl
57.1 x 57.1 x 153.4
