Koede/cephalo-1/arm-pin-hinge/out_1m_13/stl/root_bearing_cap_x1.stl

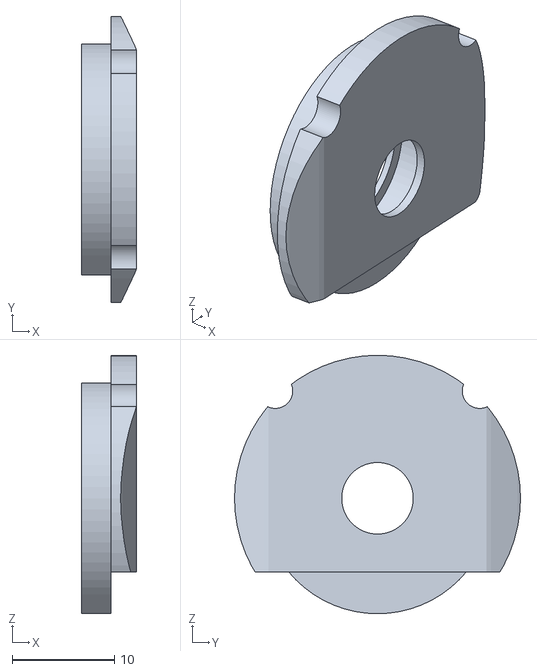
[picture p40: CAD file, 2026-11-10]
arm-pin-hinge/out_1m_13/stl/root_bearing_cap_x1.stl
5.40 x 28.0 x 25.3
