Koede/cephalo-1/arm-pin-hinge/out_700_9/stl/tip_vertebra_x1.stl

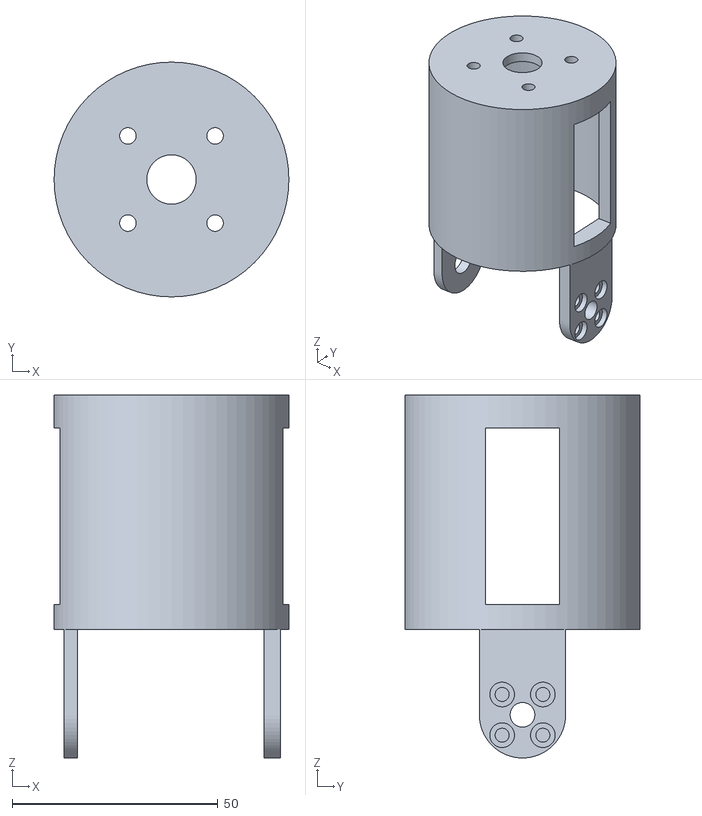
[picture p41: CAD file, 2026-11-10]
arm-pin-hinge/out_700_9/stl/tip_vertebra_x1.stl
57.1 x 57.1 x 88.3
