Koede/cephalo-1/arm-pin-hinge/out/stl/vertebra_x8.stl

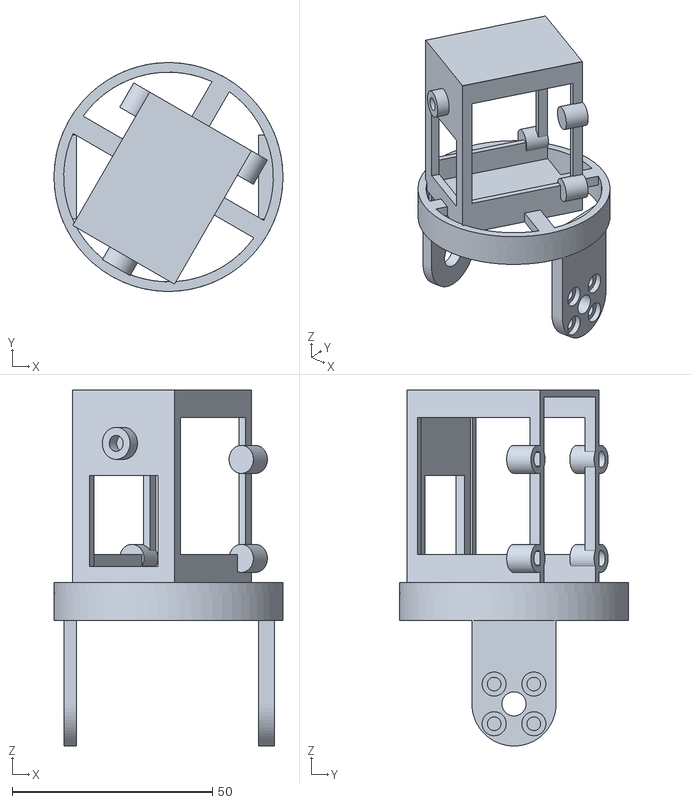
[picture p42: CAD file, 2026-11-10]
arm-pin-hinge/out/stl/vertebra_x8.stl
57.1 x 57.1 x 88.8
