Koede/cephalo-1/arm-pin-hinge/out_1m_13/stl/pinion_20T_m1_7075_x1.stl

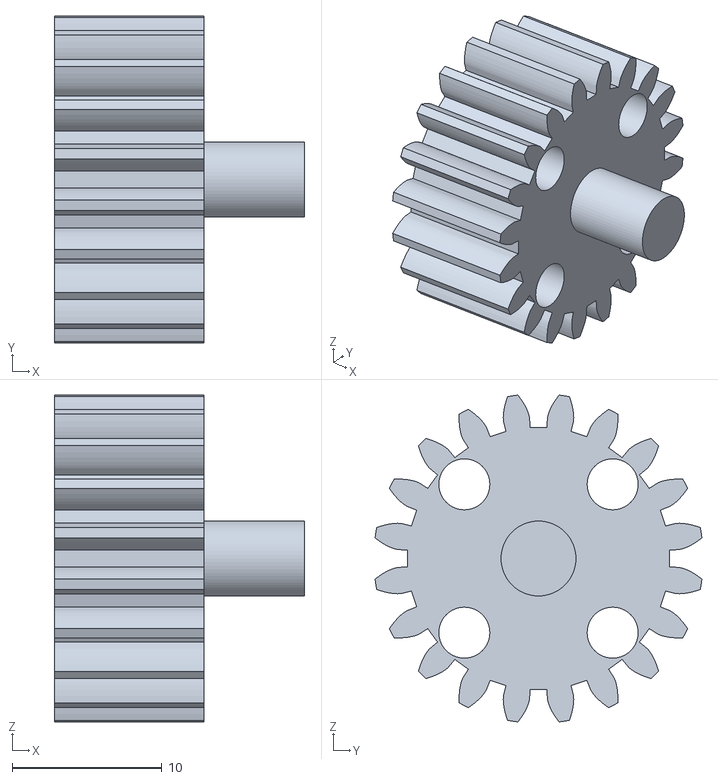
[picture p43: CAD file, 2026-11-10]
arm-pin-hinge/out_1m_13/stl/pinion_20T_m1_7075_x1.stl
16.7 x 21.8 x 21.8
