Koede/cephalo-1/arm-pin-hinge/out_1m_7/stl/vertebra_x6.stl

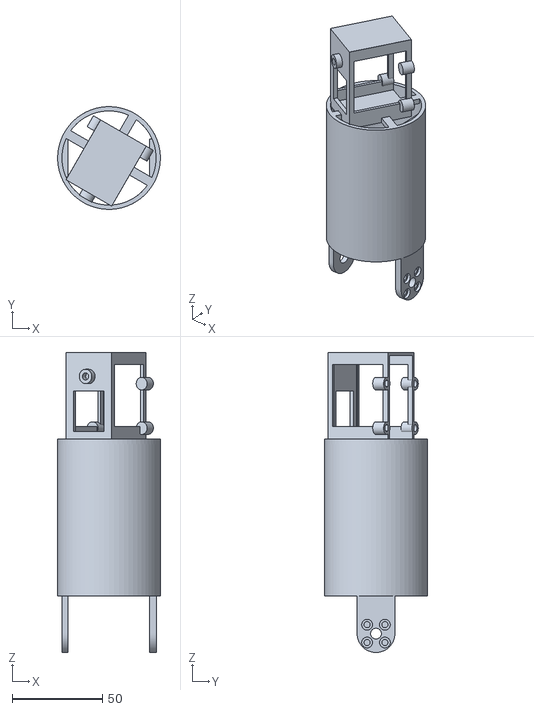
[picture p44: CAD file, 2026-11-10]
arm-pin-hinge/out_1m_7/stl/vertebra_x6.stl
57.1 x 57.1 x 166.7
