Koede/cephalo-1/spec-sheet/cad_alt90/stl/tip_vertebra_x1.stl

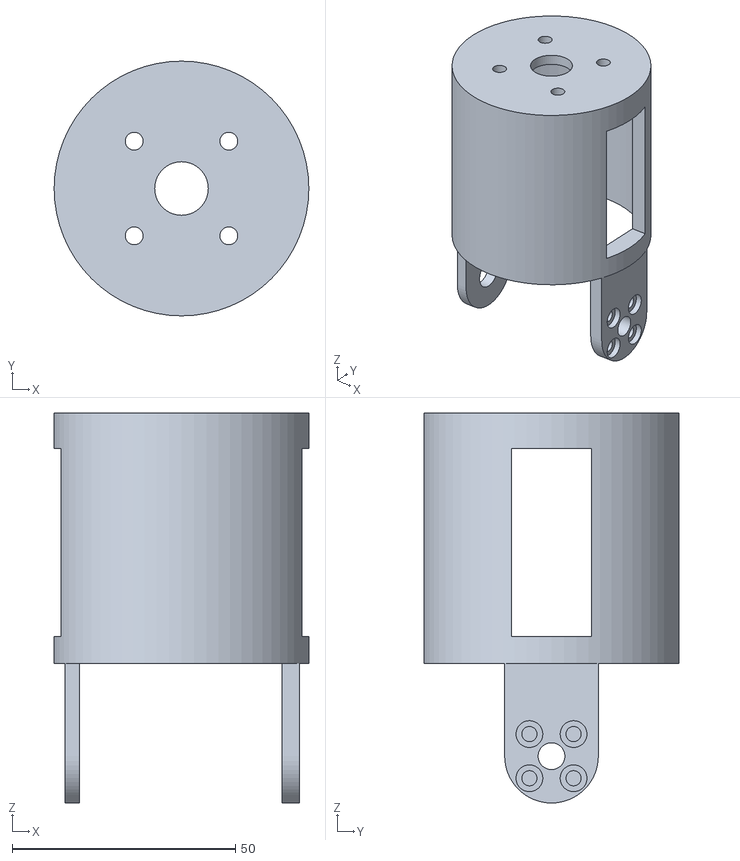
[picture p45: CAD file, 2026-11-10]
spec-sheet/cad_alt90/stl/tip_vertebra_x1.stl
57.1 x 57.1 x 87.4
