Koede/cephalo-1/arm-canted-hinge/out/stl/vertebra_07.stl

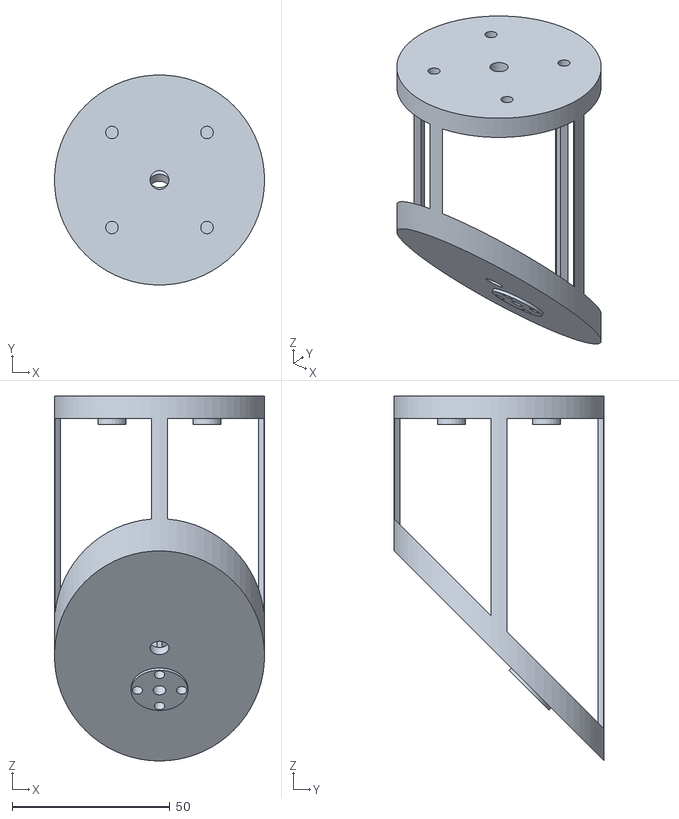
[picture p46: CAD file, 2026-11-10]
arm-canted-hinge/out/stl/vertebra_07.stl
66.6 x 66.6 x 115.6
