Koede/cephalo-1/arm-pin-hinge/out_1m_13/mantle_port_cutters_x8_r110.stl

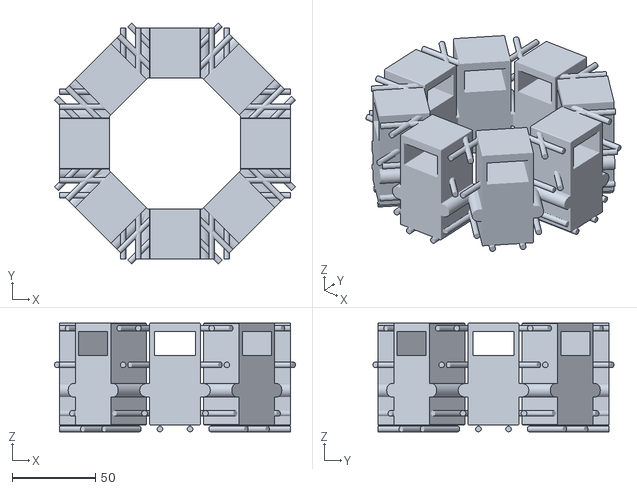
[picture p47: CAD file, 2026-11-10]
arm-pin-hinge/out_1m_13/mantle_port_cutters_x8_r110.stl
144.3 x 144.3 x 65.1
