Koede/cephalo-1/arm-canted-hinge/out/stl/root_socket.stl

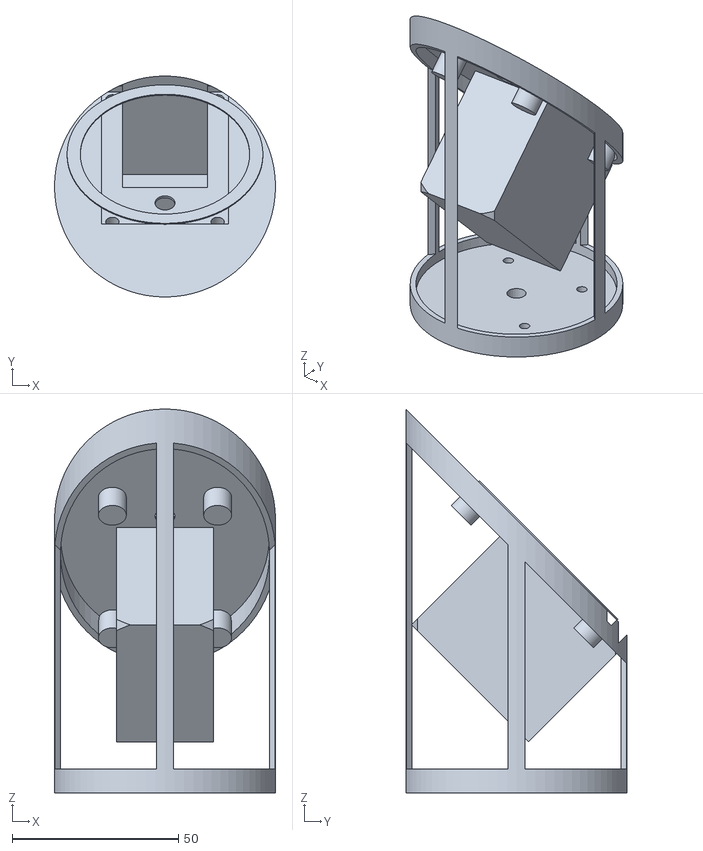
[picture p48: CAD file, 2026-11-10]
arm-canted-hinge/out/stl/root_socket.stl
66.6 x 66.6 x 115.6
