Koede/cephalo-1/arm-pin-hinge/out_1m_13/mantle_port_template.dxf

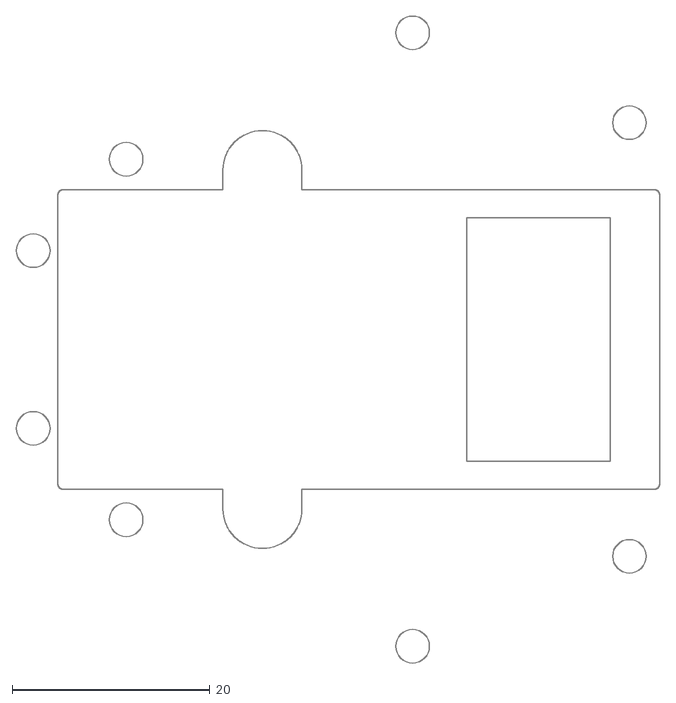
[picture p49: CAD file, 2026-11-10]
arm-pin-hinge/out_1m_13/mantle_port_template.dxf
65.1 x 65.5
