Koede/cephalo-1/arm-pin-hinge/out_1m_13/stl/root_socket_x1.stl

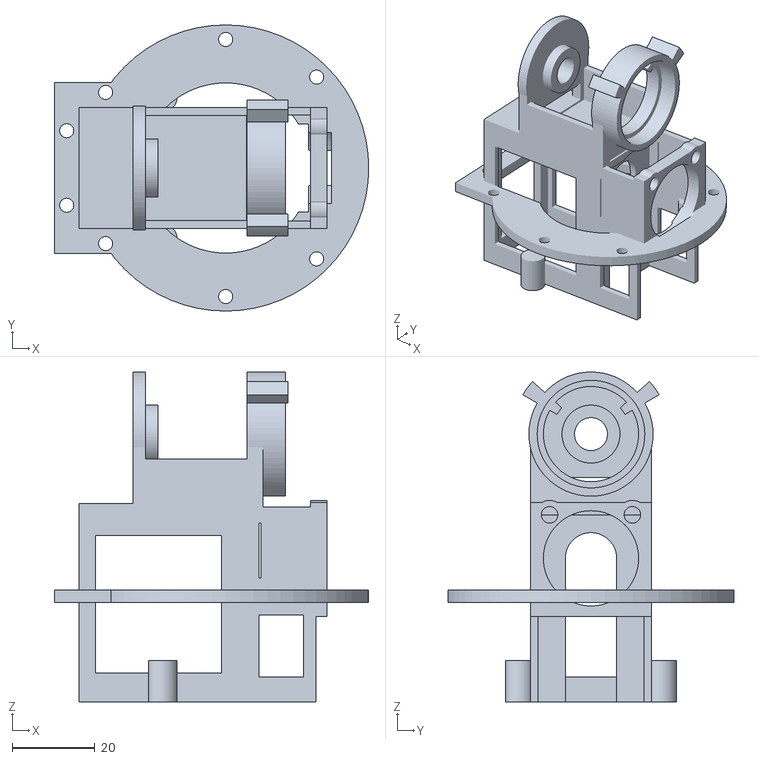
[picture p50: CAD file, 2026-11-10]
arm-pin-hinge/out_1m_13/stl/root_socket_x1.stl
76.0 x 69.1 x 79.7
