Koede/cephalo-1/arm-pin-hinge/out_1m_13/stl/gear_40T_m1_7075_x1.stl

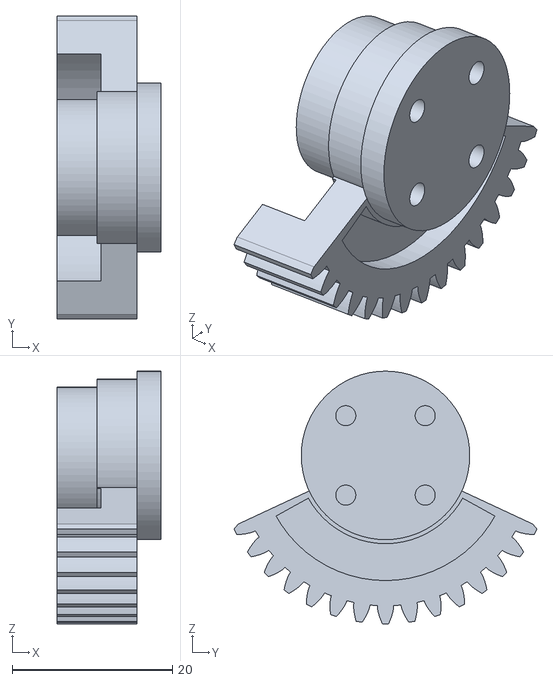
[picture p51: CAD file, 2026-11-10]
arm-pin-hinge/out_1m_13/stl/gear_40T_m1_7075_x1.stl
13.0 x 37.8 x 31.5
