Koede/cephalo-1/arm-pin-hinge/out_1m_13/stl/root_end_cap_x1.stl

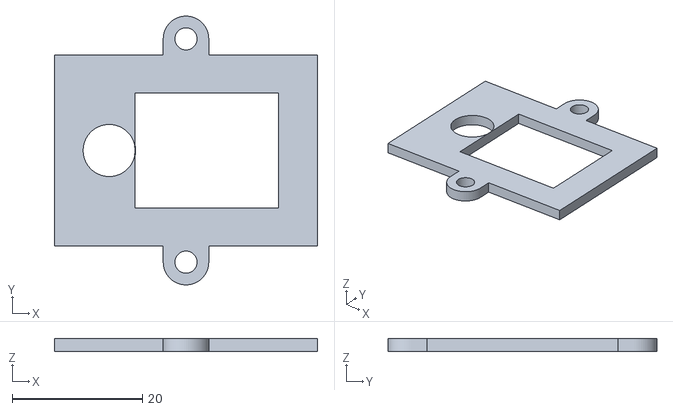
[picture p52: CAD file, 2026-11-10]
arm-pin-hinge/out_1m_13/stl/root_end_cap_x1.stl
40.4 x 41.3 x 2.00
