Koede/cephalo-1/(list of files, cad)

Other CAD files:
arm-pin-hinge/out_1m_13/stl/vertebra_x12.stl
spec-sheet/cad_alt90/stl/vertebra_x12.stl
arm-canted-hinge/out/stl/vertebra_05.stl
arm-pin-hinge/out_700_9/stl/vertebra_x8.stl
arm-canted-hinge/out/stl/vertebra_03.stl
arm-canted-hinge/out/stl/vertebra_01.stl
