Koede/cephalo-1/joint-study/results/cephalo-joint-study.html

Cephalo-1 · 8 arms · pin hinge, 60° helix · arm length 1 m (Forest, Nov 9)

# Cephalo-1 Joint Study

The study was rerun with 1 m arms: 94,048 arm designs from 101 joint types. The main design is now the pin hinge in a 60° helix, 1 m long with 13 joints, STS3250s in joints 0 to 4 and claw fans of about 16 N: an 18.8 mm shape miss. Joint 0 drives through a 2:1 gear, which takes the lift-test miss from 345 mm to 5.9 mm; the robot is 15.08 kg with a thrust-to-weight ratio of 1.150. On today's 10.8 N fans only 7-joint arms fly at 1 m.

94,048 arm designs101 joint types28 families 136 pass every gate42 on the Pareto frontSpearman vs earlier grid 0.84

## Main design: 1 m arm, 13 joints, 16 N claw fans, geared root

Pin-hinge vertebra and a 9-joint arm (585 mm build); the 1 m and 700 mm builds use the same vertebra stretched to their pitch

Pin-hinge vertebra and a 9-joint arm (585 mm build); the 1 m and 700 mm builds use the same vertebra stretched to their pitch

The main design is the pin hinge in a 60° helix, 1 m long with 13 joints: STS3250 servos in joints 0 to 4 and STS3215 beyond, one 31 g vertebra printed twelve times per arm, collision-free to ±90° per joint. On today's 10.8 N claw fans no 1 m arm with more than 7 joints passes the thrust-to-weight gate (1.15), so this build was chosen together with claw fans of about 16 N. Joint 0 now drives through a 2:1 gear (see the root fix below). The highlighted row is the main design before that fix; the other two are the options that were compared.

Option | Length mm | Joints | Pitch mm | Arm g | Robot kg | T/W | Shape miss mm (as built) | Wave RMS 0.25 Hz | 0.5 Hz | 1 Hz | Lift RMS mm
(a) 1 m on today's thrustSTS3250 in joints 0-2, STS3215 in joints 3-6 · today's fans (10.8 N each) | 1000 | 7 | 142.9 | 920 | 11.38 | 1.15 | 60.0 | 20.2 | 97.3 | saturates | 138.2
(b) 1 m with bigger claw fansSTS3250 in joints 0-4, STS3215 in joints 5-12 · 16 N claw fans, 48 % more fan thrust | 1000 | 13 | 76.9 | 1243 | 14.71 | 1.18 | 18.8 | 38.1 | 106.1 | saturates | 344.8
(c) 700 mm on today's thrustSTS3250 in joints 0-3, STS3215 in joints 4-8 · today's fans (10.8 N each) | 700 | 9 | 77.8 | 854 | 11.36 | 1.15 | 30.7 | – | 11.7 | 26.8 | 6.3

16 N per claw fan, 13.2 N at hover7 to 7.5 inch prop, 2807 motor, 6Sabout 270 W per fan at hover, 2.2 kW for eight45 A ESC130 g tip budget

Claw fan spec, sized from the T-Motor 2807 1250KV bench table on a 7.5 inch prop at 6S: 16 N at about 76 % throttle and 21.4 N at full. A 5 inch 2207 tops out at 15.1 N, so it cannot hold 13.2 N for hover with margin. The pan-tilt tip wrist keeps 0.62 thrust-sphere coverage with a 190 mm disc at a 60 mm offset (0.72 for the old 90 mm disc). Nothing has been bought.

Arm g is the arm outside the mantle, from the CAD. Shape miss is for the arm as built, with every joint at the same pitch, so it runs a little above the sweep's figure for the same joint count. Wave RMS is the tip error in mm when the arm tracks a travelling bend at that frequency; "saturates" means the servos hit their torque limit for most of the test, and a dash means that frequency was not run. For reference, the 585 mm build: 9 joints, 10.95 kg, T/W 1.20, 26.4 mm miss. Extra thrust a 1 m arm needs over today's: about 4 % for 9 joints, 19 % for 13, 31 % for 16. CAD and STLs for all three are in octopus-drone/arm-pin-hinge/ (out_1m_7, out_1m_13, out_700_9).

### Root fix: 2:1 gear on joint 0

The 345 mm lift-test miss came from the start of the test: the arm begins straight out and level with the fans off and is commanded to the walking stance in one jump. Straight out, gravity needs 7.2 N·m at joint 0 against the STS3250's 4.9 N·m, so the arm folds and never reaches the stance. Started from the stance, the same arm lifts its foot to 13 mm. The adopted fix drives joint 0 through a 2:1 spur stage (9.8 N·m, 2.2 rad/s at the joint) and keeps every command under 80 % of the servo's rated speed. 36 variants were run; the main ones are below.

lift 5.9 mm (was 345)curl step 86 mm (was 386)wave 0.5 Hz 62 mm (was 106)+46.2 g per arm in CAD, robot 15.08 kgT/W 1.150

Fix | Added g per arm | T/W | Lift RMS mm | Curl step miss mm | Wave 0.5 Hz mm | Slowest root joint rad/s
As locked in (STS3250, no fix) | 0 | 1.179 | 344.8 | 386.0 | 106.1 | 4.4
As locked in, lift test started from the stance | 0 | 1.179 | 13.0 | 386.0 | – | 4.4
No hardware change, raised at servo speed | 0 | 1.179 | 126.7 | 386.0 | – | 4.4
2:1 gear on joint 0, raised at servo speed | 45 | 1.151 | 5.9 | 85.9 | 62.5 | 2.2
1.5:1 gear on joint 0, raised at servo speed | 45 | 1.151 | 8.0 | 247.6 | – | 2.9
2:1 gear on joints 0 and 3, raised at servo speed | 90 | 1.124 | 5.1 | 86.1 | 54.6 | 2.2
3:1 gear on joint 0, 2:1 on joint 3, raised at servo speed | 90 | 1.124 | 4.5 | 165.3 | – | 1.5
Second STS3250 on joints 0 and 3, raised at servo speed | 169 | 1.080 | 6.8 | 98.3 | – | 4.4
Feetech STS3095 in joint 0, raised at servo speed | 120 | 1.107 | 7.6 | 10.9 | – | 3.2
Torsion spring on joint 0, raised at servo speed | 15 | 1.170 | 203.2 | 93.7 | – | 4.4
Claw fan 4 N while the leg swings, raised at servo speed | 0 | 1.179 | 17.3 | 386.0 | – | 4.4
Claw fan 4 N only while the arm rises, raised at servo speed | 0 | 1.179 | 14.0 | 386.0 | 106.1 | 4.4
2:1 gear on joint 0 | 45 | 1.151 | 346.8 | 85.9 | – | 2.2
Second STS3250 on joint 0 | 84 | 1.127 | 359.5 | 172.4 | – | 4.4
Feetech STS3095 in joint 0 | 120 | 1.107 | 273.2 | 10.9 | – | 3.2
ROBOTIS XM540-W270 in joint 0 | 90 | 1.124 | 313.6 | 39.7 | – | 3.1
Torsion spring on joint 0, full straight-out load | 15 | 1.170 | 257.4 | 93.7 | – | 4.4
Claw fan carries 7 N while the leg swings | 0 | 1.179 | 217.4 | 386.0 | – | 4.4

Gear stage (spec, nothing bought): module 1, 20T pinion on the STS3250 horn, 40T sector gear (teeth over ±65°, hard stops at ±55°) on the joint-0 pin, 30 mm centres, 10 mm face, 7075-T6 hard-anodized, a 61803 bearing under the gear and a 695 on the pinion. At STS3250 stall the teeth see 490 N, about 153 MPa bending on the pinion. The root socket is now drawn around it: the stage adds 46.2 g per arm in the CAD, inside the 46.4 g budget that keeps T/W at 1.15. A claw fan giving 4 N only while the arm rises gets the lift to 14 mm with no hardware but leaves the curl step and the wave as they were. A torsion spring fights the servo in every pose but one, and bigger servos (Feetech STS3095, ROBOTIS XM540-W270) or a second STS3250 push T/W below 1.15 (red). Runs: joint-study/sim/fix_root.py, results/root_fix.csv.

### Root socket, redrawn around the gear

added 46.2 g per arm (budget 46.4)joint 0 free ±55° to the stopsjoints 0+1 clear to ±60°servo bulge 6.8 mm on one side

Part | g | Note
Socket, printed | 30.1 | was 23.2; servo slides into a sleeve 30 mm below the hinge
End cap and bearing cap, printed | 4.0 | joint 0 no longer has a lid (−2.5 g)
40T sector gear, 7075-T6 | 15.0 | fork's horn ear bolts to its hub, same 4 × M3 circle; a 61803 sits in its inboard face
20T pinion and idler pin, 7075-T6 | 7.7 | pinion bolted to the servo horn, far end in a 695; 8 mm pin for the fork's idler ear
Bearings and hardware | 15.1 | 61803, 695, screws and inserts

The vertebrae, tip and fork are unchanged. The mantle opening needs a notch on the servo side: everything that passes through it fits a 61 × 42 mm outline (out_1m_13/mantle_cutout_joint0_frame.svg). A full webbed gear instead of the sector fits the same socket at 54 to 59 g per arm (T/W 1.146 to 1.142). Script: arm-pin-hinge/root_gear.py.

### Root bearing check

6800 static safety 0.73 → 61803 1.31 at 16 N sidewaysidler support 36 → 26 MPa (PETG → 7075)pinion bearing 1.12 → 1.68 at stallmass +0.9 g per arm, inside budget

Load case | 6800 N | 6800 safety | 61803 N | 61803 safety | PETG stub MPa | 7075 pin MPa | 685 safety | 695 safety
Hover, straight out | 403 | 2.06 | 342 | 3.71 | 4 | 1 | 1.82 | 2.74
Hover, any pose | 408 | 2.04 | 346 | 3.67 | 6 | 3 | 2.16 | 3.25
Flight, rated thrust tilted 30 deg | 707 | 1.17 | 601 | 2.11 | 10 | 5 | 1.18 | 1.78
Rated thrust, any direction | 1,143 | 0.73 | 971 | 1.31 | 28 | 20 | 1.13 | 1.70
Full throttle, any direction | 1,276 | 0.65 | 1,084 | 1.17 | 36 | 26 | 1.27 | 1.92
Walking stance | 88 | 9.43 | 75 | 16.99 | 1 | 0 | 10.06 | 15.14
Hard landing | 624 | 1.33 | 530 | 2.40 | 5 | 1 | 1.26 | 1.90
Gear at stall | 655 | 1.27 | 557 | 2.28 | 6 | 2 | 1.12 | 1.68

When the claw fan pushes across the hinge plane at the root, up to 16 N.m (rated thrust) or 22 N.m (full throttle) acts out of that plane, and the socket as first drawn carried it on a 6800 and a printed stub 31 mm apart, with the 6800 8 mm inboard of the mesh. The fix: a 61803 in a recess in the gear's inboard face, 2.5 mm from the mesh and 36.5 mm from the idler ear; an 8 mm 7075 pin for the idler ear; a 695 on the pinion. Static safety is C0 over the worst load (catalogue ratings). Still weak: the fork's printed idler ear (24 MPa at full throttle sideways) and the servo spline's side load (about 280 N at stall, no published limit). Joints 1 to 4 are checked below. Keeping each claw fan's push within 30° of straight up holds the root under 3 N.m out of plane. Script: joint-study/sim/bearing_loads.py, results/bearing_loads.json.

### Joints 1 to 4 side-load check

Case (worst of joints 1 to 4) | Servo output radial N | Idler side N | Printed stub MPa | Fork ears MPa
Hover, any pose | 111 | 110 | 4.6 | 7.8
Rated thrust within 30° of straight up | 191 | 196 | 8.2 | 7.6
Full throttle within 30° of straight up | 294 | 294 | 12.3 | 4.7
Rated thrust within 60° of straight up | 244 | 249 | 10.4 | 10.3
Rated thrust, any direction | 409 | 408 | 17.0 | 17.0
Full throttle, any direction | 511 | 509 | 21.3 | 7.8
Walking stance | 33 | 27 | 1.1 | 1.8
Hard landing | 189 | 141 | 5.9 | 6.6

Joints 1 to 4 have no gear, so the side load goes through the fork's two ears, 49 mm apart: one on the servo horn (the STS3250 output spline and its ball bearing), one on a printed 8 mm stub. Printed parts were rated against about 45 MPa along the layers and 25 MPa across them with Forest's 2x rule; the stub passes only with the claw fan held within 30° of straight up. The servo output carries 110 N even in hover; Feetech publishes no limit, and ROBOTIS rates its heavier XM430 at 40 N radial 10 mm from the horn. Taking that load off the servo needs a thin-section bearing between the horn ear and the cradle lid (roughly +20 to +40 g per arm) or a bench test first. Script: joint-study/sim/joint_loads.py, results/joint_loads.json.

## What the run found

- (a) 1 m on today's thrust: 7 joints, STS3250 in joints 0 to 2. 142.9 mm pitch, one 73 g vertebra printed six times per arm, 920 g per arm outside the mantle. Robot 11.38 kg, thrust-to-weight 1.15, right on the gate. 60 mm shape miss. Wave tip error 20 mm at 0.25 Hz and 97 mm at 0.5 Hz; it saturates at 1 Hz.
- (b) Main design. 1 m with 16 N claw fans: 13 joints, STS3250 in joints 0 to 4, 2:1 gear on joint 0. 76.9 mm pitch, one 31 g vertebra, 1,243 g per arm outside the mantle before the gear stage. Robot 15.08 kg, thrust-to-weight 1.150. 18.8 mm shape miss. Wave error 22 mm at 0.25 Hz and 62 mm at 0.5 Hz; 5.9 mm in the lift test.
- Root fix: straight out with the fans off, joint 0 needs 7.2 N·m against the STS3250's 4.9 N·m, so the arm folded at the start of the lift test (345 mm miss); from the stance it lifted to 13 mm. A 2:1 spur stage on joint 0 (+46.2 g per arm, now drawn into the root socket) with every move kept under 80 % of servo speed brings the lift to 5.9 mm, the curl step from 386 to 86 mm and the 0.5 Hz wave from 106 to 62 mm. Bigger servos and a second STS3250 fail the thrust-to-weight gate; a torsion spring fights the servo; a 4 N claw-fan assist while the arm rises fixes only the lift (14 mm). The redrawn socket keeps every vertebra as it was; the servo sits 30 mm below the hinge and stands 6.8 mm out of the tube on one side, so the mantle opening needs a notch there. Root bearing check: with the claw fan pushing across the hinge plane, the first socket's 6800 was loaded to 1.4 times its static rating and its printed idler stub to about PETG's limit; a 61803 under the gear mesh, an 8 mm 7075 idler pin and a 695 on the pinion bring the worst case to 0.76 of the bearing's static rating (0.85 at full throttle) for 0.9 g more, still inside the budget. Joints 1 to 4 were checked next (below).
- Joints 1 to 4 side loads: the printed ears pass in every case, and the printed stub passes Forest's 2x rule only while each claw fan pushes within 30° of straight up (12.3 MPa against 12.5). The weak part is the STS3250's own output: the horn side carries 110 N in hover in any pose, 190 to 290 N with the fan within 30° of up and up to 510 N pushed sideways, about 9 mm out from the case. Feetech publishes no limit; ROBOTIS rates its heavier XM430 at 40 N. The fix that takes the load off the servo is a thin-section bearing between the fork's horn ear and the cradle lid at joints 1 to 4, roughly +20 to +40 g per arm (T/W about 1.13); a 0 g alternative is to bench-test an STS3250 under 110 and 300 N first. Now drawn: a 6705 thin-section bearing (25 x 32 x 4 mm, 834 N static) on the servo lid round the horn, inside the 57.1 mm tube, 32 g per arm, T/W 1.061 to 1.045; joints still swing +-90 deg clear. It carries the worst case at 0.61 of its static rating.
- Central prop (replaces the EDF): under the dome wins. A 17 inch prop on a T-Motor MN5212 KV420 (70 A class ESC) sits 125 mm under the hub centre; above the dome a 22 inch MN6007II would need a mast about 190 mm tall to clear the arms when they arch up while walking. The 22 inch is more efficient per watt, but above the dome the fast slipstream hits the dome and the eight arm roots and pushes down with about 22 % of its thrust, against about 4 % under it, so hover power comes out the same (about 3.5 kW with a 1 kg pack, against 5.6 kW with the EDF). Hover with the central prop under the dome: 1 kg pack 2.6 min at T/W 1.13, 1.6 kg 4.0 min at 1.09, 2.3 kg 5.4 min at 1.04 (the EDF gave 1.6, 2.6 and 3.5 min). Above the dome cannot hover the 2.3 kg pack inside the claw fans' rating. The cost of under: blade tips 75 mm off the ground while walking and 22 mm from the legs in stance 4, so a ring guard (about 0.1 kg) is worth adding. Pack: Forest picked 2.3 kg. No 6S LiPo weighs that; the design now uses a Tattu 6S 16,000 mAh 30C (1.99 kg): 4.5 min hover at T/W 1.06, 181 A against its 480 A. The 2.65 kg Tattu 22,000 mAh gives 5.8 min at T/W 1.02. Two DOGCOM semi-solid 22,000 mAh packs (2.78 kg) would give about 11.5 min, but at T/W 1.01 and 88 % of their 220 A continuous rating.
- Claw prop clearance while walking: with a foot down, no fan direction within 30° of straight up is clear: the arm's own last links come down onto the claw and sit in the prop disc. The claw fans stay stopped while their foot is down, the wrist pivot needs about 120 mm of ground clearance for a stopped 7 inch prop (unless the props fold), and at take-off each claw tips 40 to 60° back toward the body or waits until it is clear.
- Mantle ports: cutters and a template for the new 61 x 42 mm opening with the notch for the root servo sleeve are in arm-pin-hinge/out_1m_13 (mantle_port_*). Two root flange holes moved from 30° and 330° to 45° and 315° to clear it, at no mass change. At the study's assumed 110 mm hub radius the eight root flanges overlap each other; they clear from 124.5 mm.
- Claw pickups: pickups are by the claw only. From the walking stance the arm lifts 0.4 to 0.6 kg at Forest's 2x rule; reached out straight it can lift almost nothing extra.
- Still unchecked: the real claw mass. The sim allows 130 g at the tip; the 2807 motor alone is 53 g, and the claw, wrist, ESC and prop are not designed or weighed yet.
- Claw fans for the main design: 16 N each, 13.2 N continuous at hover with the root gear, from a 7 to 7.5 inch prop on a 2807 motor at 6S. About 270 W per fan at hover and 2.2 kW for all eight, before the EDF. A 5 inch FPV motor peaks near 15 N and is too small.
- (c) 700 mm on today's thrust: 9 joints, STS3250 in joints 0 to 3. 77.8 mm pitch, one 32 g vertebra, 854 g per arm outside the mantle. Robot 11.36 kg, thrust-to-weight 1.15. 30.7 mm shape miss, 27 mm wave error at 1 Hz and 6 mm in the lift test.
- Length sweep on today's thrust: 9 joints fly up to 800 mm (on all STS3215 at 800 mm, thrust-to-weight 1.18); 900 mm and 1 m fly only with 7 joints. A 1 m arm needs about 4 % more thrust for 9 joints, 19 % for 13 and 31 % for 16.
- Speed: a 1 m arm moves about four times slower than the 585 mm arm. The root torque scales with length squared at fixed arm mass per metre, and every 1 m design saturates in the 1 Hz wave test. Flight-stress torque at the root is 1.6 to 3.1 times STS3215 stall at 1 m.
- Architectures: tendons, graded chains and push-pull rods have no feasible design at 1 m on today's thrust, even with low-friction tendons. With 16 N claw fans, 2,391 designs pass, 72 of them graded chains, and the best 11-joint arms with two roll joints reach 13 DOF.
- Correction to the 585 mm results: two-axis joints (universal and omni-wrist) were charged one servo per joint for mass and size while being given two drives. The 585 mm figures for them ("22 DOF most DOF", "universal 15 DOF 8.82 kg") were too light and are withdrawn. The fix is in the 1 m run; the pin-hinge figures were not affected.
- Bigger claw fans (Forest, Nov 9): an MN5008 KV400 with a 16x5.4 carbon 2-blade prop (25 N rated, 33.5 N full, +107 g per claw) and two DOGCOM 22 Ah semi-solid packs hover for 17 min at T/W 1.35 (16 min and 1.29 with the bent claw), against 4.4 min today. The 9 to 10.5 inch FPV props gain nothing; the big slow props do. The arm then needs 8 mm 7075 idler pins on joints 1 to 4, the fan held within 60° of up (horn bearing 0.46 of its rating), and 4 to 5 N of fan lift when reaching straight out (joint 3 would be at 1.06 of stall). The 16 inch disc rules out the pan-tilt wrist, so the fan is fixed on the claw axis and the claw bends round the prop edge: out 233 mm behind the prop, a fixed 90° bend, jaws 90 mm past it. The jaws can't be the foot (2.1 times the tip servo's stall), so walking moves onto the arm a little back from the claw. Separately, the stance poses already ask 1.34 and 1.20 of stall from joints 6 and 9.
- Folding fan pod (Forest's pick, Nov 10): the 16 inch fan rides on a pod hinged across its own axis, so thrust passes through the hinge and a 20 g STS3032 only swings it. The pod is the thumb: it closes on a fixed finger, opens to 67 mm, and holds about 0.6 kg at half stall. 248 g at the tip; robot 18.91 kg, 16.9 min hover, T/W 1.34, better than the fixed bent claw (16.0 min, 1.29). Arm loads match the plain 16 inch fan (7075 idler pins on joints 1 to 4, fan within 60° of up). Standing on the folded finger makes walking worse in some rolls (joints 6 and 9 to 1.81 and 1.65 of stall) and needs the prop parked, so walking stays on the arm's underside.
- Walking on the folded pod (Forest's pick, Nov 10): standing on the finger in the study's stance poses asks 1.44 and 1.24 of stall from joints 6 and 9. A torque-aware stance fixes it with no new parts: the arm arches up over its root and comes down nearly vertical onto the finger, so the load runs along the lower arm. With the hub 250 mm up, every joint stays at or under 0.33 of stall over the whole step (0.73 with twice the foot load). The prop parks itself: braked to a stop, then over the last 1.6° of the fold a 2-lobe collar on the prop adapter lands on a sprung post on the palm and turns the blades across, about 5 g per claw (16.9 min hover, T/W 1.34). The stopped motor's cogging still needs measuring.
- Moves on the folded pod (Forest: "Yes, check the moves", Nov 10): one arm traced through a whole step at hub 250 mm (90 mm stance stroke, unload, 45 mm lift, swing, set-down, reload), with the straight servo moves between poses checked too. Sideways and diagonal steps are clean: the worst joint reaches 0.45 of stall (joints 6 / 9 at most 0.45 / 0.41, tip servos 11 / 12 at most 0.42 / 0.21), under the 0.67 limit. An in-out step centred on the stance runs 16 mm into the next arm at its inner end; moving the stroke 25 mm outward makes it clean at 0.41. The pod folds and unfolds only with the arm raised straight up (every joint 0.01, pod servo 0.41 at the park point, disc 33 mm clear of its own arm). A straight move up to that pose would hit 0.87 and brush the next arm, so the arm follows a planned path, pulling in low then standing up, peaking at 0.45. Two solver faults found on the way (arm coiling through itself, one blade swept into a neighbour mid-move) are now hard limits.

## Arm bench

### Arm

Main: Pin hinge, 60° helixPin hingeServo-shell vertebraServo chain with U-bracketsMost DOF: Pin hinge

### Pose

Walking stanceStraight270° curlSpiralCoil on poleS-curveTwisted bend

servo nodepassive / tendon nodetarget shape

Drag to orbit, scroll to zoom. Poses are the solver's best fit to each target shape; walking stance is the claw-down foot pose.

## Top arms after dynamics

# | Joint | Drive | Nodes | DOF | Shape miss mm | Wave tip RMS mm | Walk torque util | Safe touchdown m/s | Robot kg | Cost $ | Build h | Score

1 | Pin hinge (clevis)M3_bolt_PETG · alt90 · rigid | servo per nodeSTS3215 | 7 | 7 | 48.5 | 858.8 | 0.61 | 0.50 | 10.91 | 1082 | 14 | 0.058
2 | Servo-shell vertebra (servo case is the link)horn+idler_PETG · alt90 · rigid | servo per nodeSTS3215 | 7 | 7 | 48.5 | 852.6 | 0.61 | 0.49 | 11.28 | 1123 | 19 | 0.056
3 | Servo chain with U-brackets (current Cephalo-1 arm)printed_U_bracket_PETG · alt90 · rigid | servo per nodeSTS3215 | 7 | 7 | 48.5 | 856.2 | 0.61 | 0.49 | 11.39 | 1128 | 19 | 0.055
4 | Rolling-contact joint, crossed straps (CORE-style)TPU_flexure_straps_PETG · alt90 · rigid | servo per nodeSTS3215 | 7 | 7 | 47.6 | 827.7 | 0.79 | 0.47 | 10.83 | 1078 | 13 | 0.054
5 | Servo chain with U-brackets (current Cephalo-1 arm)printed_U_bracket_PETG · helix60 · rigid | servo per nodeSTS3215 | 7 | 7 | 49.0 | 967.6 | 0.41 | 0.42 | 11.39 | 1128 | 19 | 0.035
6 | Pin hinge (clevis)M3_bolt_PETG · helix60 · rigid | servo per nodeSTS3215 | 7 | 7 | 49.0 | 968.0 | 0.41 | 0.43 | 10.91 | 1082 | 14 | 0.035
7 | Gear-meshed rolling (geared double hinge, 2:1)printed_spur_PETG · alt90 · rigid | servo per nodeSTS3215 | 7 | 7 | 41.6 | 845.3 | 0.67 | 0.45 | 11.09 | 1078 | 21 | 0.035
8 | Servo-shell vertebra (servo case is the link)horn+idler_PETG · helix60 · rigid | servo per nodeSTS3215 | 7 | 7 | 49.0 | 967.5 | 0.41 | 0.42 | 11.28 | 1123 | 19 | 0.035
9 | Pin hinge (clevis)M3_bolt_PETG · alt90_roll4 · rigid | servo per nodeSTS3215 | 7 | 8 | 39.2 | 991.9 | 0.64 | 0.48 | 11.07 | 1170 | 15 | 0.026
10 | Gear-meshed rolling (geared double hinge, 2:1)printed_spur_PETG · alt90_roll4 · rigid | servo per nodeSTS3215 | 7 | 8 | 39.9 | 1062.8 | 0.67 | 0.45 | 11.25 | 1166 | 22 | 0.024
11 | Rolling-contact joint, crossed straps (CORE-style)TPU_flexure_straps_PETG · planar · rigid | servo per nodeSTS3215 | 7 | 7 | 115.4 | 916.9 | 0.87 | 0.47 | 10.83 | 1078 | 13 | 0.021
12 | Gear-meshed rolling (geared double hinge, 2:1)printed_spur_PETG · helix60 · rigid | servo per nodeSTS3215 | 7 | 7 | 49.5 | 983.1 | 0.71 | 0.55 | 11.09 | 1078 | 21 | 0.017

At 1 m every arm saturates in the 1 Hz wave test, so the dynamics factor is small for all of them and the order mostly follows the static score; the slower wave tests in the main-design table above are the fairer measure at this length. Score is the static composite (DOF, fluidity, loads, precision, mass, build effort) times the MuJoCo dynamics factor. Walk util is peak joint torque over capacity in claw-down stance (under 1 passes). Safe touchdown is the vertical speed the arm absorbs with fans holding hover weight; an unpowered 150 mm drop breaks every design.

## Architecture check at 1 m: baseline, low-friction tendons, bigger claw fans

Architecture | Feasible (baseline) | Best score | Feasible (μ 0.07, 300 N, 400 cm³) | Best score | Feasible (16 N claw fans) | Best score | Min walk util | Main failures
3-section tendons | 0 / 19,824 | – | 0 | – | 0 | – | 1.16 | walk_load, flight_load
base-box tendons | 0 / 23,520 | – | 0 | – | 0 | – | 1.55 | walk_load, flight_load
graded servo chain | 0 / 5,120 | – | 0 | – | 72 | 0.386 | 0.22 | tw, walk_load
push-pull rods | 0 / 9,744 | – | 0 | – | 0 | – | 7.11 | walk_load, flight_load
root servos + base-box tendons | 0 / 17,472 | – | 0 | – | 0 | – | 1.31 | walk_load, flight_load
servo in every node | 136 / 18,368 | 0.492 | 136 | 0.492 | 2,319 | 0.600 | 0.14 | walk_load, flight_load

The second scenario gives tendons PTFE-lined friction, 300 N line tension and two thirds more mantle space, to see whether the remote-drive families are ruled out by the assumptions or by the physics. The third gives each claw fan 16 N instead of 10.8 N and charges 40 g more per claw. Gate failures over the whole baseline sweep: walk load 84,048 · flight load 83,056 · struct 70,896 · mantle 45,380 · tw 41,735 · walk 28,536 · chan 19,356 · fits 3,888.

## Tip fan joint

Wrist | Actuators | Thrust-sphere coverage | Moving mass g | Added root moment N·m | Score
Pan-tilt servo gimbal (roll about arm + tilt) | 2 (2 at tip) | 0.64 | 55 | 0.14 | 0.428
Single-axis 360 deg fan tilt + tentacle roll module | 2 (1 at tip) | 0.61 | 45 | 0.09 | 0.421
Bevel differential wrist (both servos behind the joint) | 2 (0 at tip) | 0.50 | 35 | 0.03 | 0.328
Milenkovic 2-axis CV wrist | 2 (0 at tip) | 0.59 | 50 | 0.11 | 0.275
Double Hooke joint with roll | 3 (1 at tip) | 0.50 | 60 | 0.17 | 0.256
Rosheim double-gimbal CV wrist | 3 (0 at tip) | 0.50 | 65 | 0.20 | 0.176
Canted three-roll wrist | 3 (0 at tip) | 0.73 | 90 | 0.34 | 0.159
Agile Eye 3-RRR spherical wrist | 3 (0 at tip) | 0.33 | 45 | 0.09 | 0.158
Printed pure-rolling spherical parallel wrist | 3 (0 at tip) | 0.37 | 60 | 0.17 | 0.155
Omni-Wrist III style printed linkage | 2 (0 at tip) | 0.52 | 70 | 0.23 | 0.153
Duta-Stanisic semicircular-link wrist | 2 (0 at tip) | 0.73 | 90 | 0.34 | 0.140
2-RSS pushrod ball joint | 2 (0 at tip) | 0.12 | 25 | -0.03 | 0.096

Coverage is the share of thrust directions reachable without the 90 mm fan disc hitting the tentacle. The geometric ceiling is 0.56 at 20 mm offset and 0.83 at 60 mm, so offset matters as much as the mechanism.

## Plots

DOF against shape fluidity, all feasible designs

DOF against shape fluidity, all feasible designs

Sub-scores of the top 15

Sub-scores of the top 15

Best score per family and architecture

Best score per family and architecture

Robot mass against DOF

Robot mass against DOF

## Check against the earlier 9-type grid

prior | prior joints | prior miss mm | here dof | here miss mm | here arrangement
base-box rolling vertebrae | 19.0 | 6.0 | 19.0 | 11.4 | –
current servo chain | 9.0 | 12.0 | 11.0 | 27.4 | –
geared double hinges | 8.0 | 12.0 | 11.0 | 25.9 | –
servo shells | 9.0 | 12.0 | 11.0 | 27.4 | –
cross-axis flexures | 17.0 | 18.0 | 23.0 | 11.9 | –
3-section rolling | 8.0 | 18.0 | 8.0 | 33.7 | –
cycloidal modules | 6.0 | 19.0 | 8.0 | 47.8 | –
one-piece printed rolling | 8.0 | 22.0 | 11.0 | 36.1 | –
TPU spine | 4.0 | 40.0 | 7.0 | 57.3 | –

## Run it on Saturn

Code, catalog and CSVs are in the project folder under octopus-drone/joint-study/. On Saturn: pip install -r requirements.txt, then python3 run_study.py (12 workers by default), python3 rank.py and python3 build_page.py. Add JOINT_SCENARIO=tendon_optimistic for the low-friction case.
