Koede/cephalo-1/joint-study/results/585mm/validation_vs_earlier_grid.csv

prior | prior_joints | prior_miss_mm | here_dof | here_miss_mm | here_arrangement
base-box rolling vertebrae | 19 | 6 | 23 | 1.7 | alt90_roll4
current servo chain | 9 | 12 | 11 | 13.5 | alt90_roll4
geared double hinges | 8 | 12 | 11 | 15.5 | alt90_roll4
servo shells | 9 | 12 | 11 | 13.5 | alt90_roll4
cross-axis flexures | 17 | 18 | 23 | 2.0 | alt90_roll4
3-section rolling | 8 | 18 | 8 | 20.5 | alt90_roll4
cycloidal modules | 6 | 19 | 5 | 47.2 | alt90
one-piece printed rolling | 8 | 22 | 11 | 22.2 | alt90_roll4
TPU spine | 4 | 40 | 7 | 34.8 | omni_roll4
