Koede/cephalo-1/joint-study/results/best_per_family.csv

family | family_name | prior_label | variant | range_deg | arrangement | actuation | n_nodes_req | local_servo | root_servo | remote_drive | compliance | grade_split | N | nv | pitch_fit | L | arm_mass_struct | free_frac | nbr_hit_frac | ws_vox | dexterity | ws_vol_L | miss_arc_curl | miss_spiral_curl | miss_s_curve | miss_helix_coil | miss_side_arc | miss_twisted_bend | miss_tip_hook | miss_mean_mm | miss_planar_mm | miss_3d_mm | walk_perr_mm | walk_ang_deg | walk_ok | walk_ok_frac | util_walk | util_flight_nom | util_flight_max | struct_walk | struct_flight | arm_mass_g | box_mass_g | total_mass_kg | thrust_to_weight | hover_N_per_fan | land_peak_N | land_g | util_land | struct_land | land_stroke_mm | foot_allow_N | touchdown_v_safe | touchdown_v_safe_unpowered | foot_k_N_per_mm | tip_err_mm | eta_min | coupling | n_drives_arm
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
