Koede/cephalo-1/joint-study/results/fluid_1m.csv

scenario | fit | joints | wave_hz | feasible | wave_tip_rms_mm | wave_sat_frac | lift_tip_rms_mm | sag_mm | step_settle_s | total_mass_kg | tw
today | STS3215 throughout | 7 | 0.25 | True | 32.32384784580869 | 0.3423333333333333 | 301.84418425012194 | 7.1824036699684415 | 9.9 | 10.907207182887845 | 1.2018725009362663
today | STS3215 throughout | 7 | 0.5 | True | 1175.3765144759138 | 0.984 | 301.84418425012194 | 7.1824036699684415 | 9.9 | 10.907207182887845 | 1.2018725009362663
today | STS3250 to 35 %, STS3215 beyond | 7 | 0.25 | True | 20.21211530218674 | 0.104 | 138.2108034963136 | 10.085603825209597 | 9.9 | 11.375207182887845 | 1.1524249329583989
today | STS3250 to 35 %, STS3215 beyond | 7 | 0.5 | True | 97.33666783052757 | 0.7196666666666667 | 138.2108034963136 | 10.085603825209597 | 9.9 | 11.375207182887845 | 1.1524249329583989
more_thrust | STS3215 throughout | 11 | 0.25 | True | 89.99068523087479 | 0.6553333333333333 | 90.40404456305862 | 5.35288502641638 | 9.9 | 13.032007182887845 | 1.331310133406344
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
