Koede/cephalo-1/joint-study/results/fluid_len.csv

length_m | fit | joints | wave_hz | feasible | fail | miss_mean_mm | wave_tip_rms_mm | wave_sat_frac | lift_tip_rms_mm | total_mass_kg | tw | util_flight_max
0.7 | STS3215 throughout | 9 | 1.0 | True |  | 30.748102418057492 | 699.1796968860276 | 0.9106666666666666 | 60.058026357505156 | 10.737165028021492 | 1.220906295182742 | 1.3649544813894556
0.7 | STS3215 throughout | 9 | 0.5 | True |  | 30.748102418057492 | 16.33260100877722 | 0.03266666666666666 | 60.058026357505156 | 10.737165028021492 | 1.220906295182742 | 1.3649544813894556
0.7 | STS3250 to 35 %, STS3215 beyond | 9 | 1.0 | True |  | 30.748102418057492 | 26.80159089365176 | 0.006 | 6.317949492105912 | 11.361165028021492 | 1.1538493053128656 | 0.8498547223073021
0.7 | STS3250 to 35 %, STS3215 beyond | 9 | 0.5 | True |  | 30.748102418057492 | 11.66597583396244 | 0.0026666666666666666 | 6.317949492105912 | 11.361165028021492 | 1.1538493053128656 | 0.8498547223073021
0.8 | STS3215 throughout | 9 | 1.0 | True |  | 36.15952898713854 | 923.463132393298 | 0.9656666666666667 | 86.60310280964939 | 11.094645746310276 | 1.181567458292851 | 1.541908442483827
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
