Koede/cephalo-1/joint-study/results/585mm/dof_vs_fluidity.png

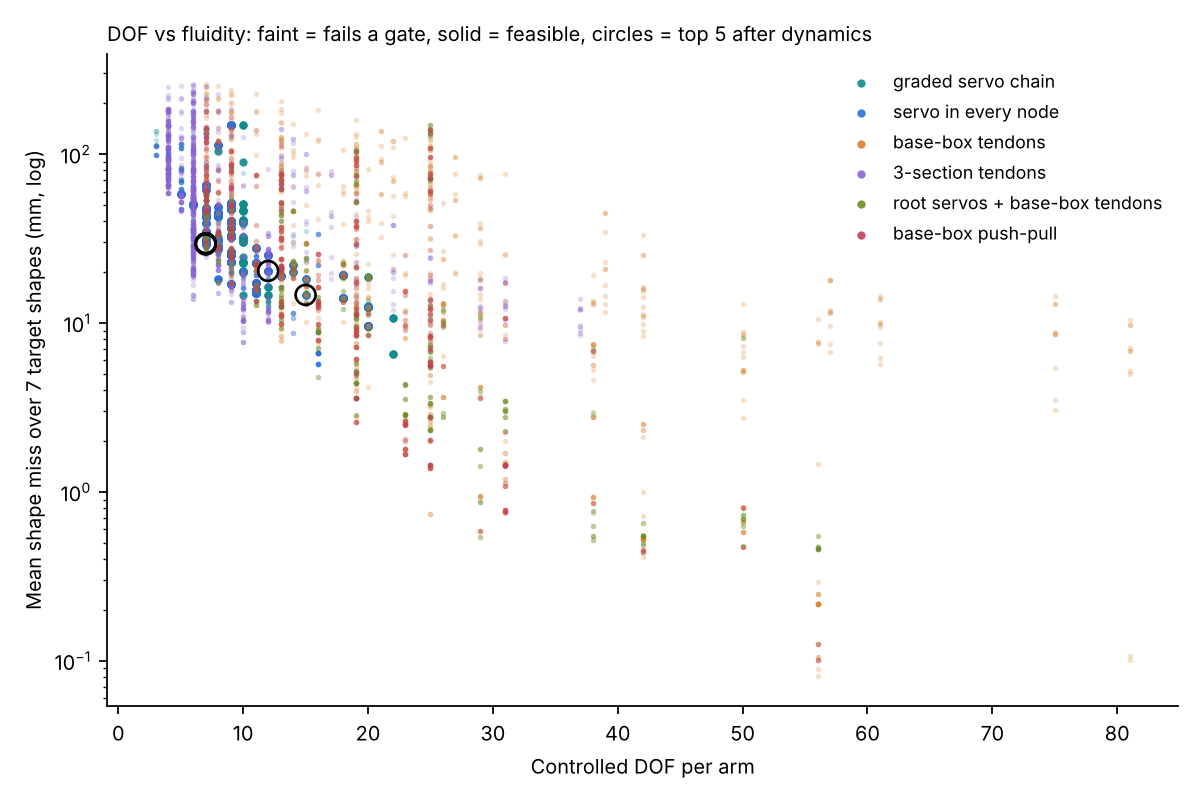
joint-study/results/585mm/dof_vs_fluidity.png
