Koede/cephalo-1/joint-study/results/585mm/mass_vs_dof.png

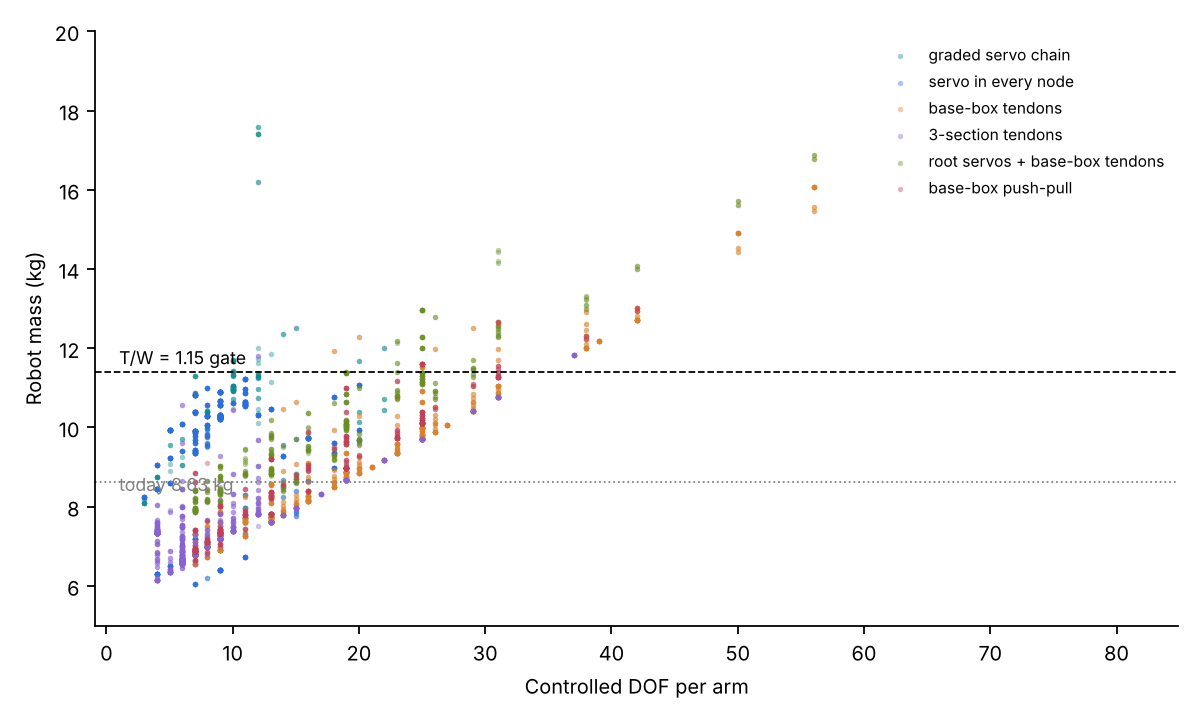
joint-study/results/585mm/mass_vs_dof.png
