Koede/cephalo-1/joint-study/results/585mm/top15_subscores.png

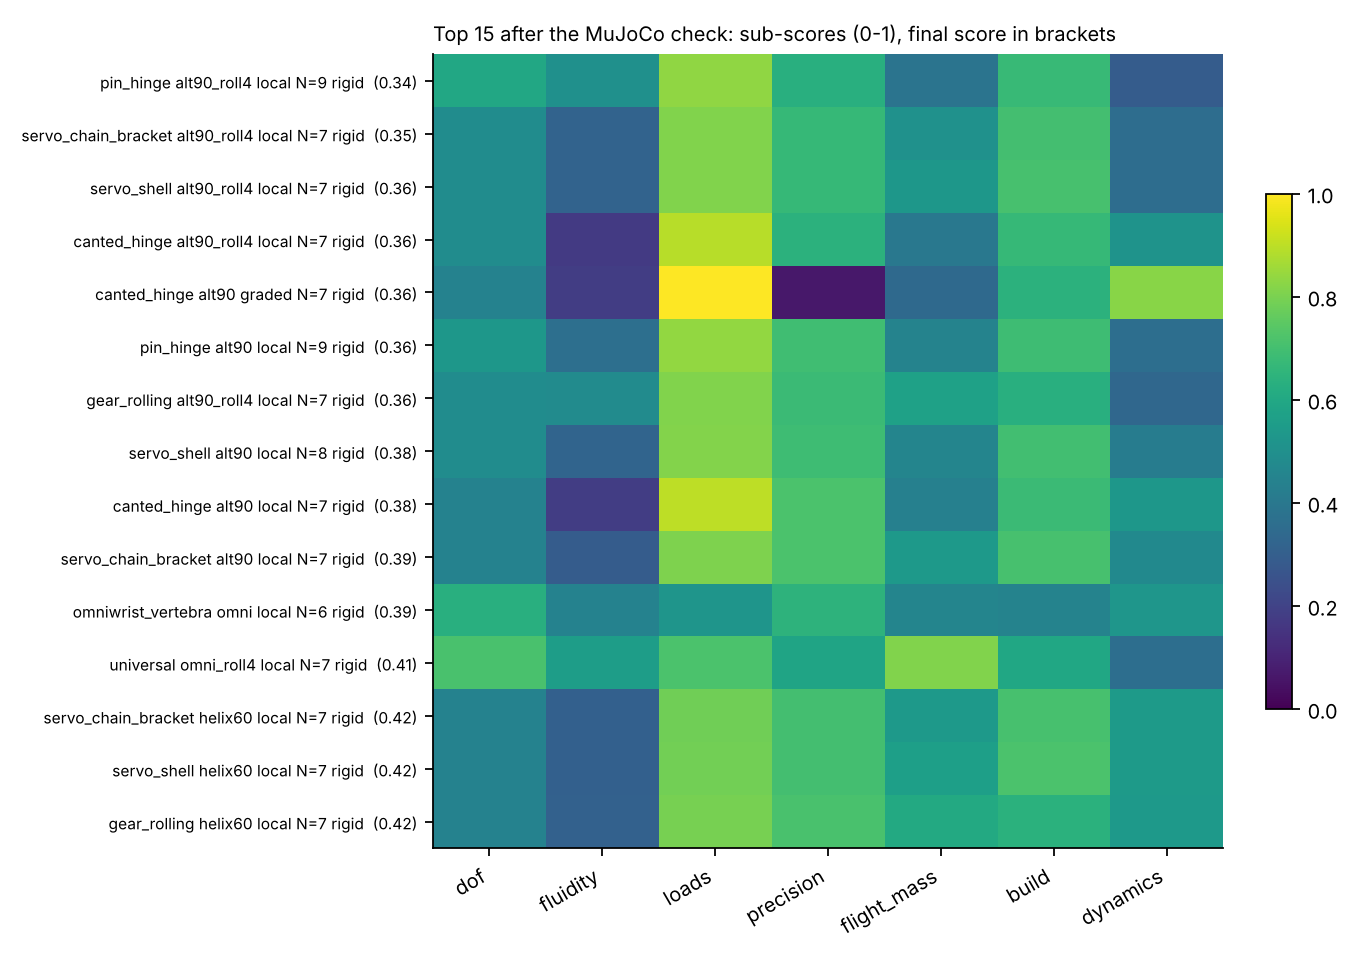
joint-study/results/585mm/top15_subscores.png
