Koede/cephalo-1/joint-study/results/dof_vs_fluidity.png

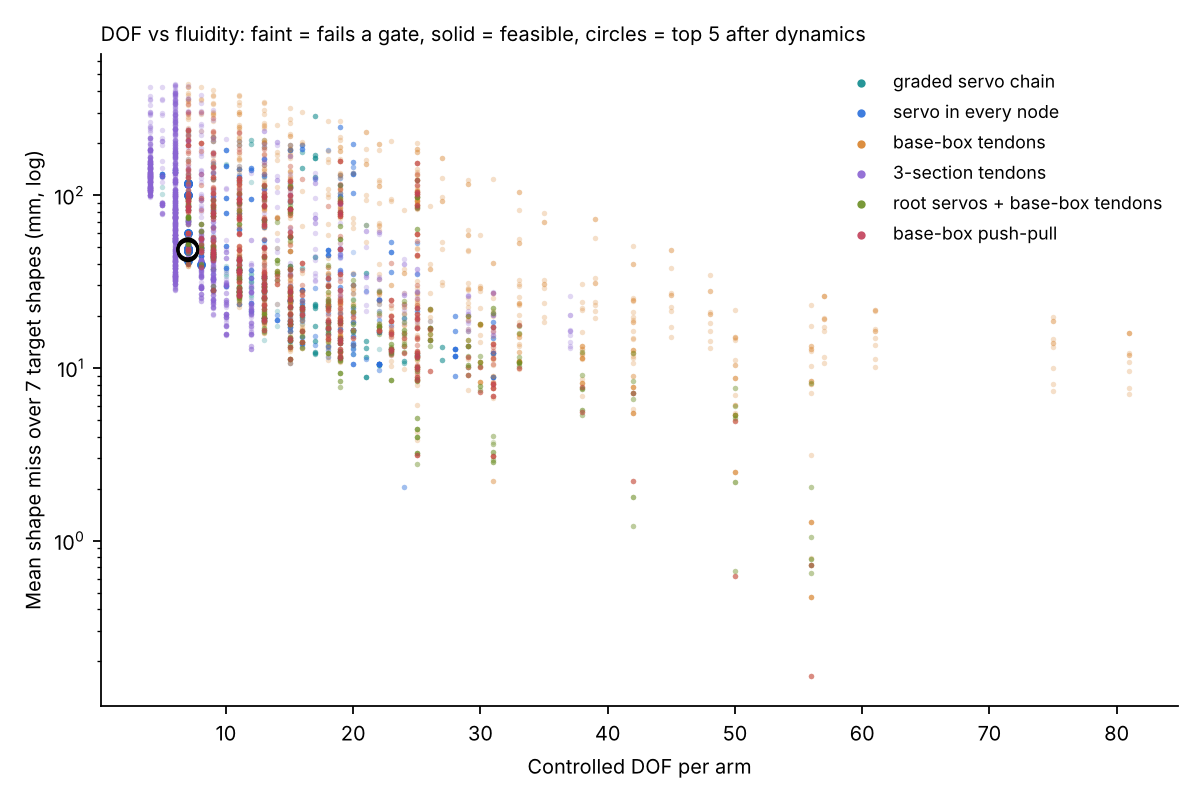
joint-study/results/dof_vs_fluidity.png
