Koede/cephalo-1/joint-study/results/mass_vs_dof.png

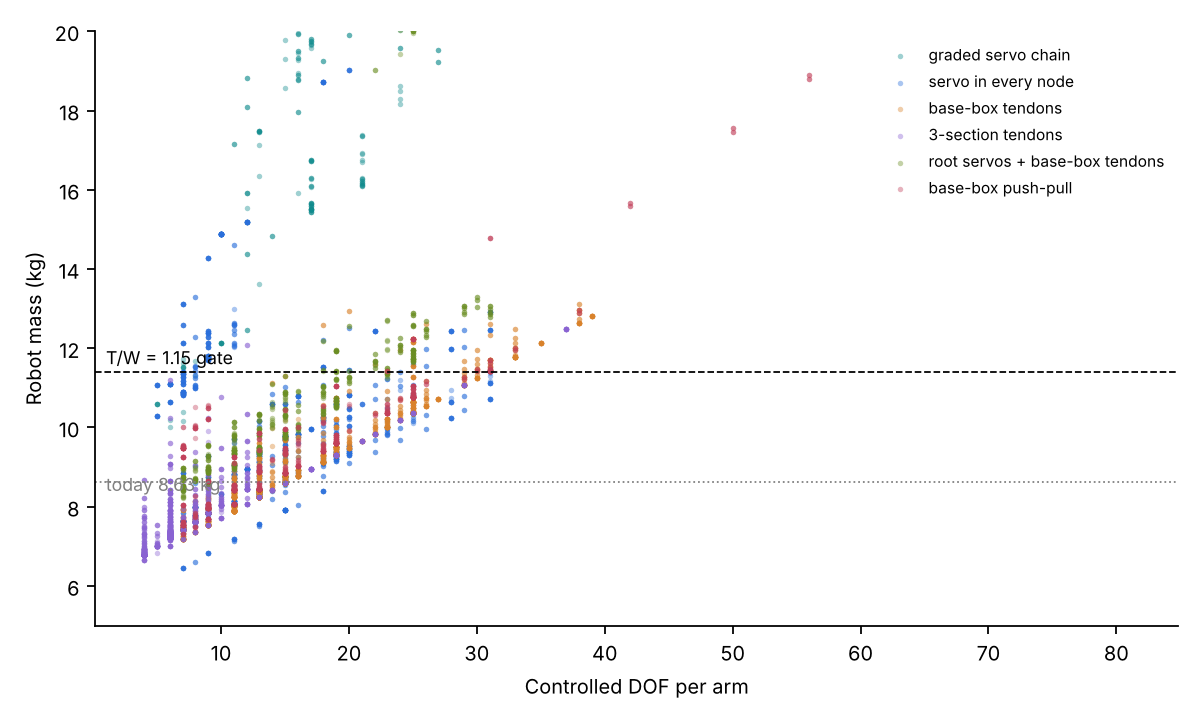
joint-study/results/mass_vs_dof.png
