Koede/cephalo-1/joint-study/results/top15_subscores.png

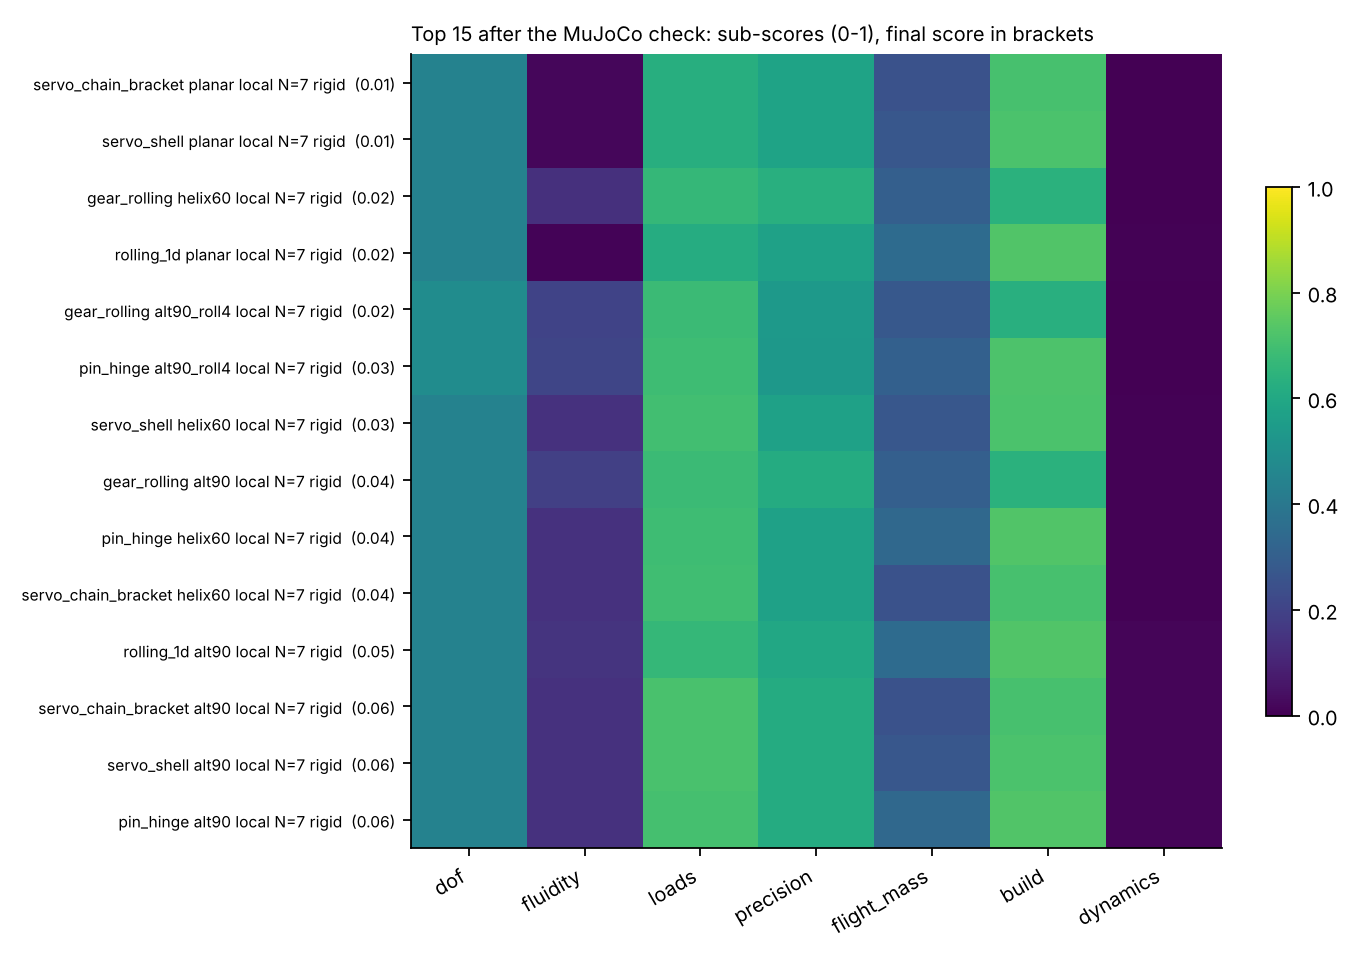
joint-study/results/top15_subscores.png
