Koede/cephalo-1/(commit log)

2026-11-10 Add Cephalo-1 octopus drone design, CAD and joint study
    Adds the design document, the pin-hinge and canted-hinge arm CAD generators
    with their printable STLs and assemblies, the joint study scripts, results
    and write-up, and the spec-sheet variant. Raw sweep data and Python caches
    are left out (see .gitignore); run_study.py and rank.py rebuild the sweep.
    [architectures_baseline.csv, architectures_more_thrust.csv, architectures_tendon_optimistic.csv, assembly_coil.stl, assembly_curl.stl, assembly_joint1_bearing.stl, assembly_pod_0deg.stl, assembly_pod_45deg.stl]
2026-11-10 Add Octopus Drone rev 4 design line (servo-clutch-rev4/)
    Design docs (rev 4 integrated design, design state, conventions, joint and
    clutch studies, rev 3 dynamics) and the Python models, MuJoCo sims, clutch
    part generators and renderers from the Octopus Drone project, kept in their
    own folder next to the pin-hinge arm. Top-level README points to it.
    Claude-Session: https://claude.ai/code/session_012jhbAFCeEXVyvqhiGH8sMm
2026-11-10 Add the pin-hinge arm spec sheet
    Adds the spec sheet page, its five section scripts, the pose, stance,
    hover-tilt and load runs that feed it, and their results. A README in
    spec-sheet/ links the live page and notes that the sheet is the living
    record for the arm. Python caches are left out as before.
